ivere27/ulva/docs/schematic/index.html

# ULVA · Schematics

Download PDF

## Pages

×

Opening schematic pages…

Drag to pan · Scroll or pinch to zoom
