ivere27/ulva/docs/images/pcb-placement.png

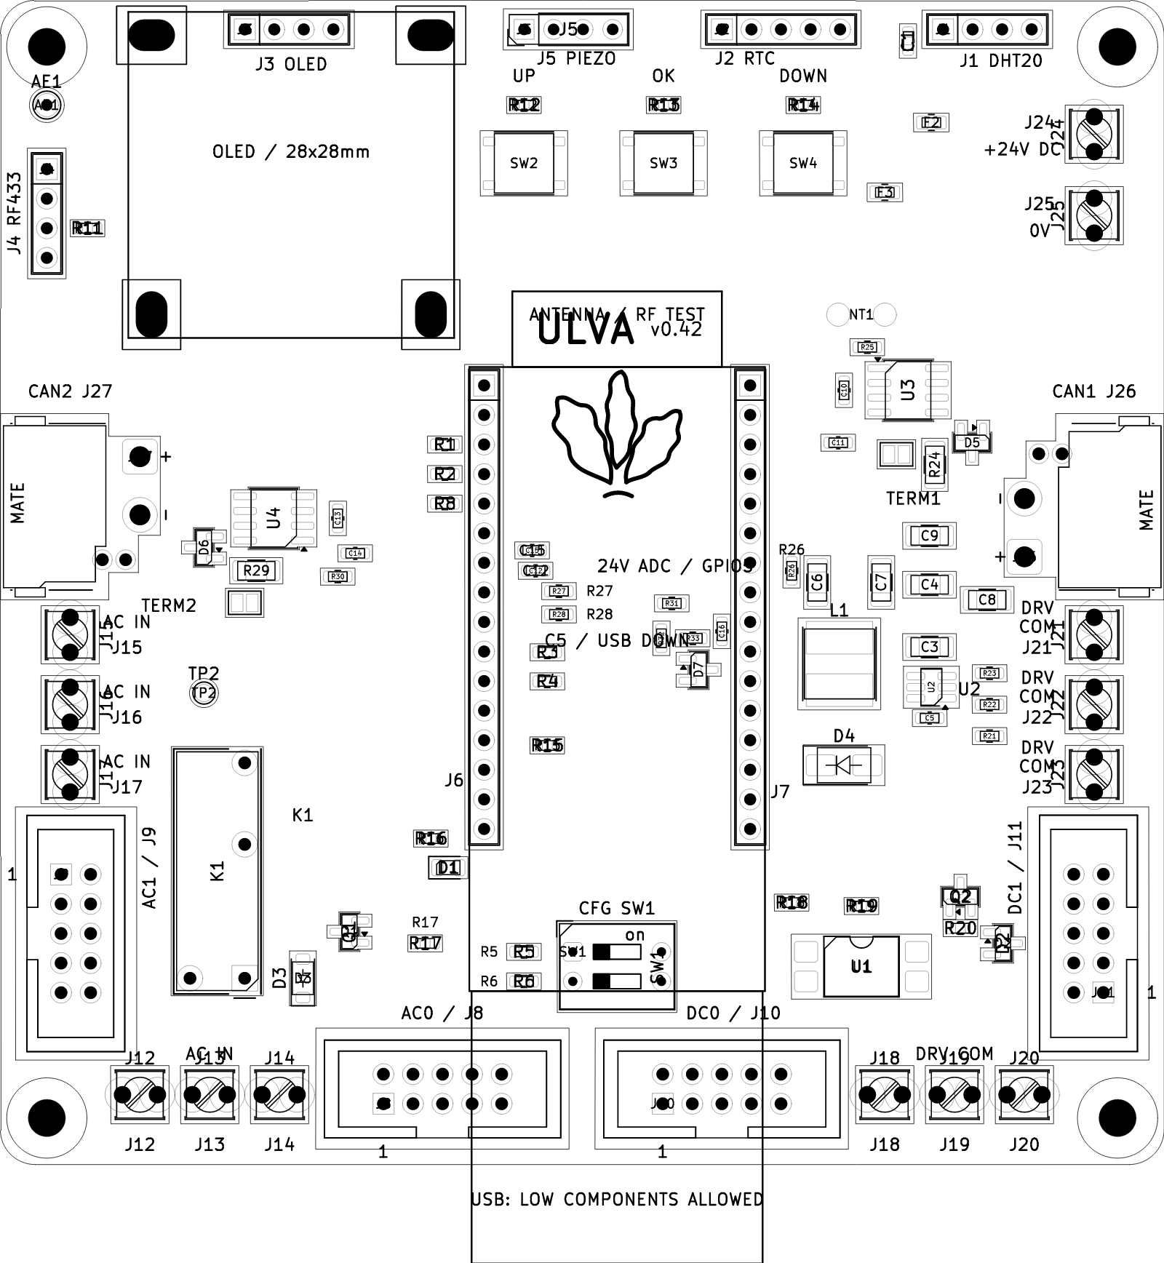
docs/images/pcb-placement.png
