ivere27/ulva/docs/schematic/schematic.pdf

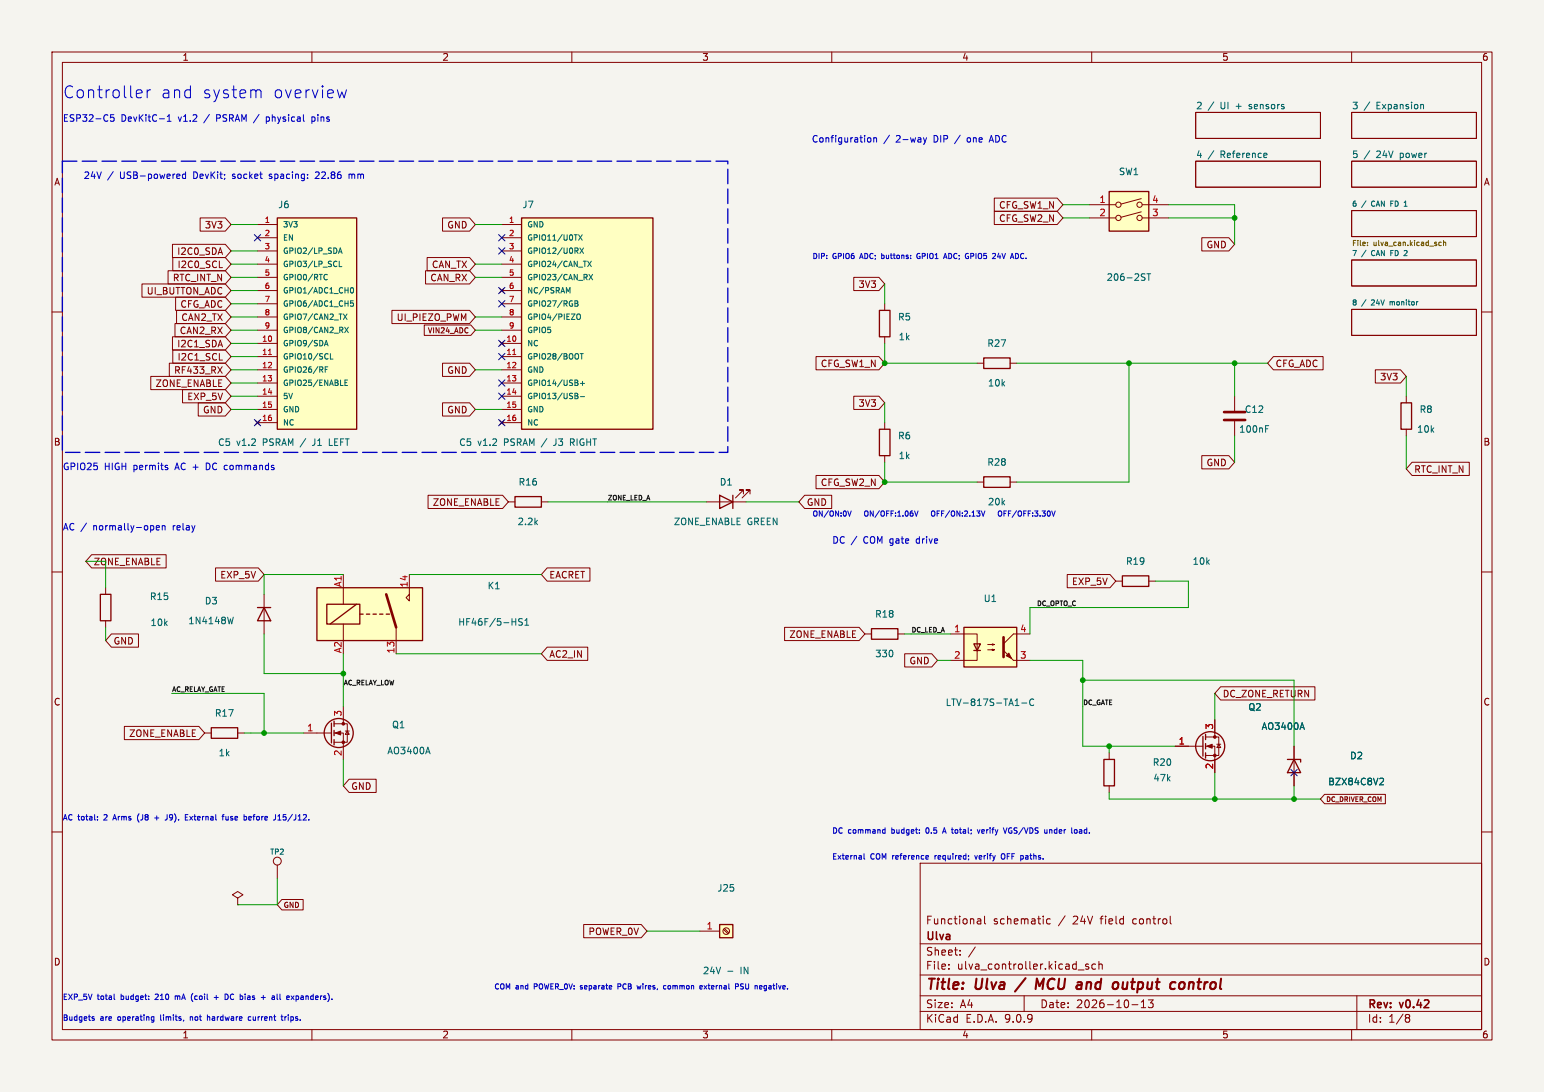
[picture p6: page 1]

6 / CAN FD 1 File: ulva_can.kicad_sch 5 / 24V power 3 / Expansion

DC / COM gate drive

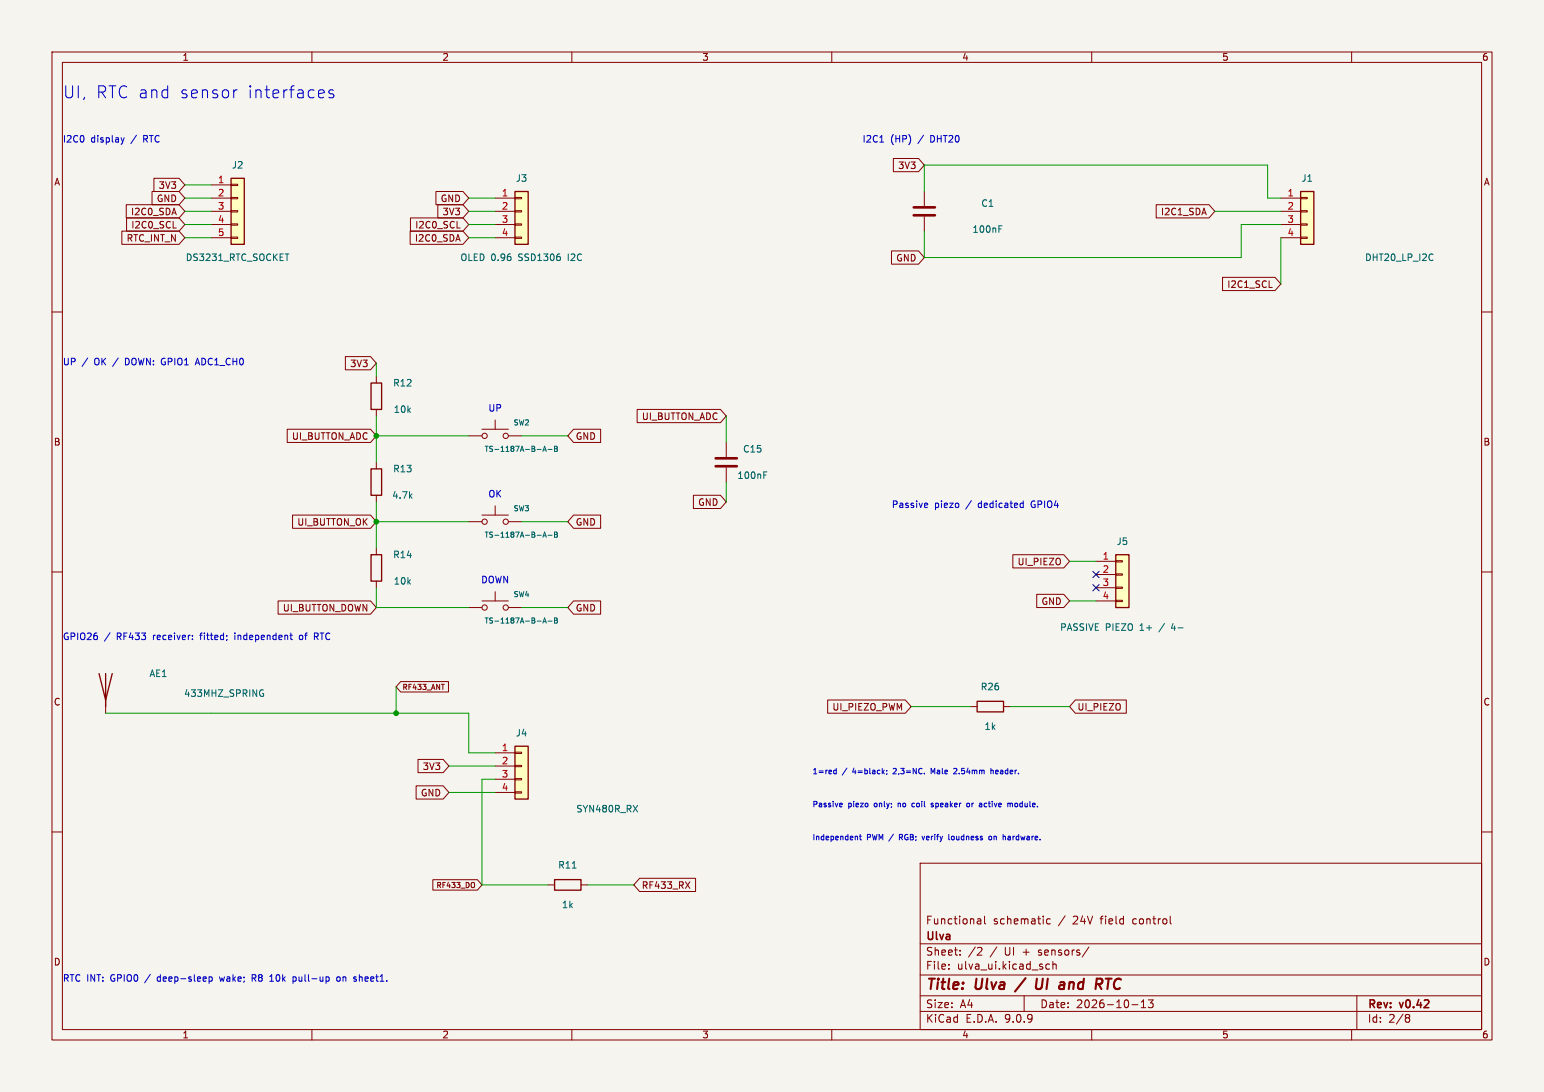
[picture p7: page 2]

UI, RTC and sensor interfaces

Id: 2/8 Title: Ulva / UI and RTC

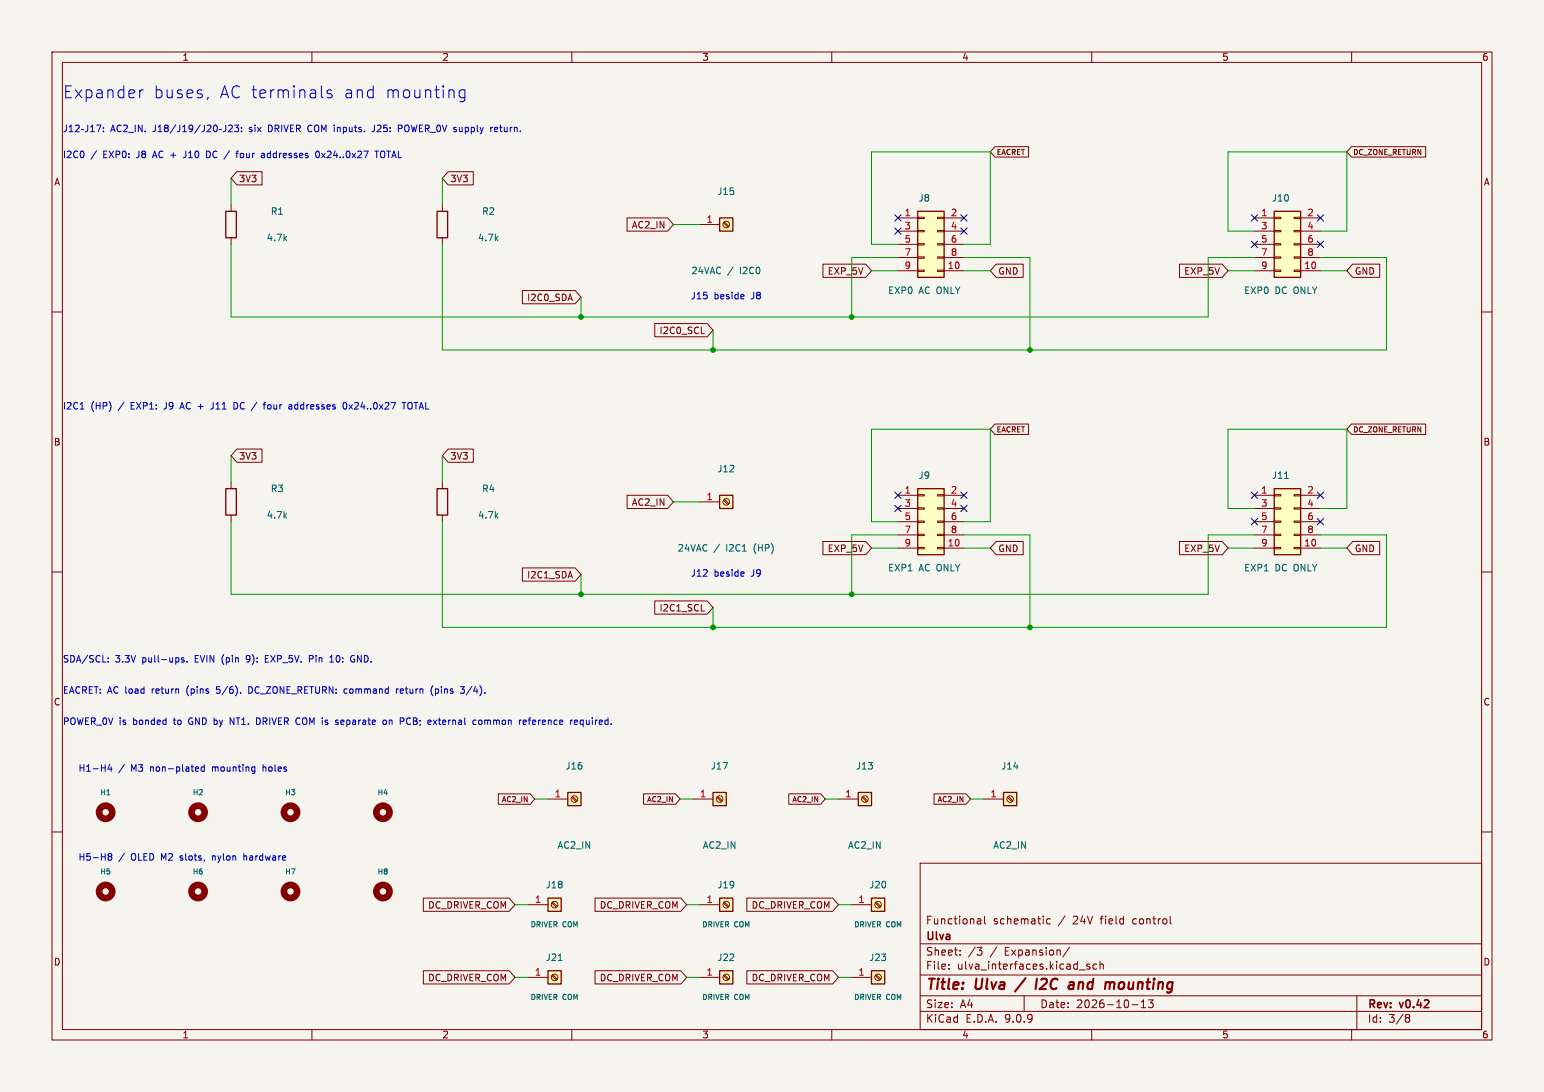
[picture p8: page 3]

Id: 3/8 Title: Ulva / I2C and mounting

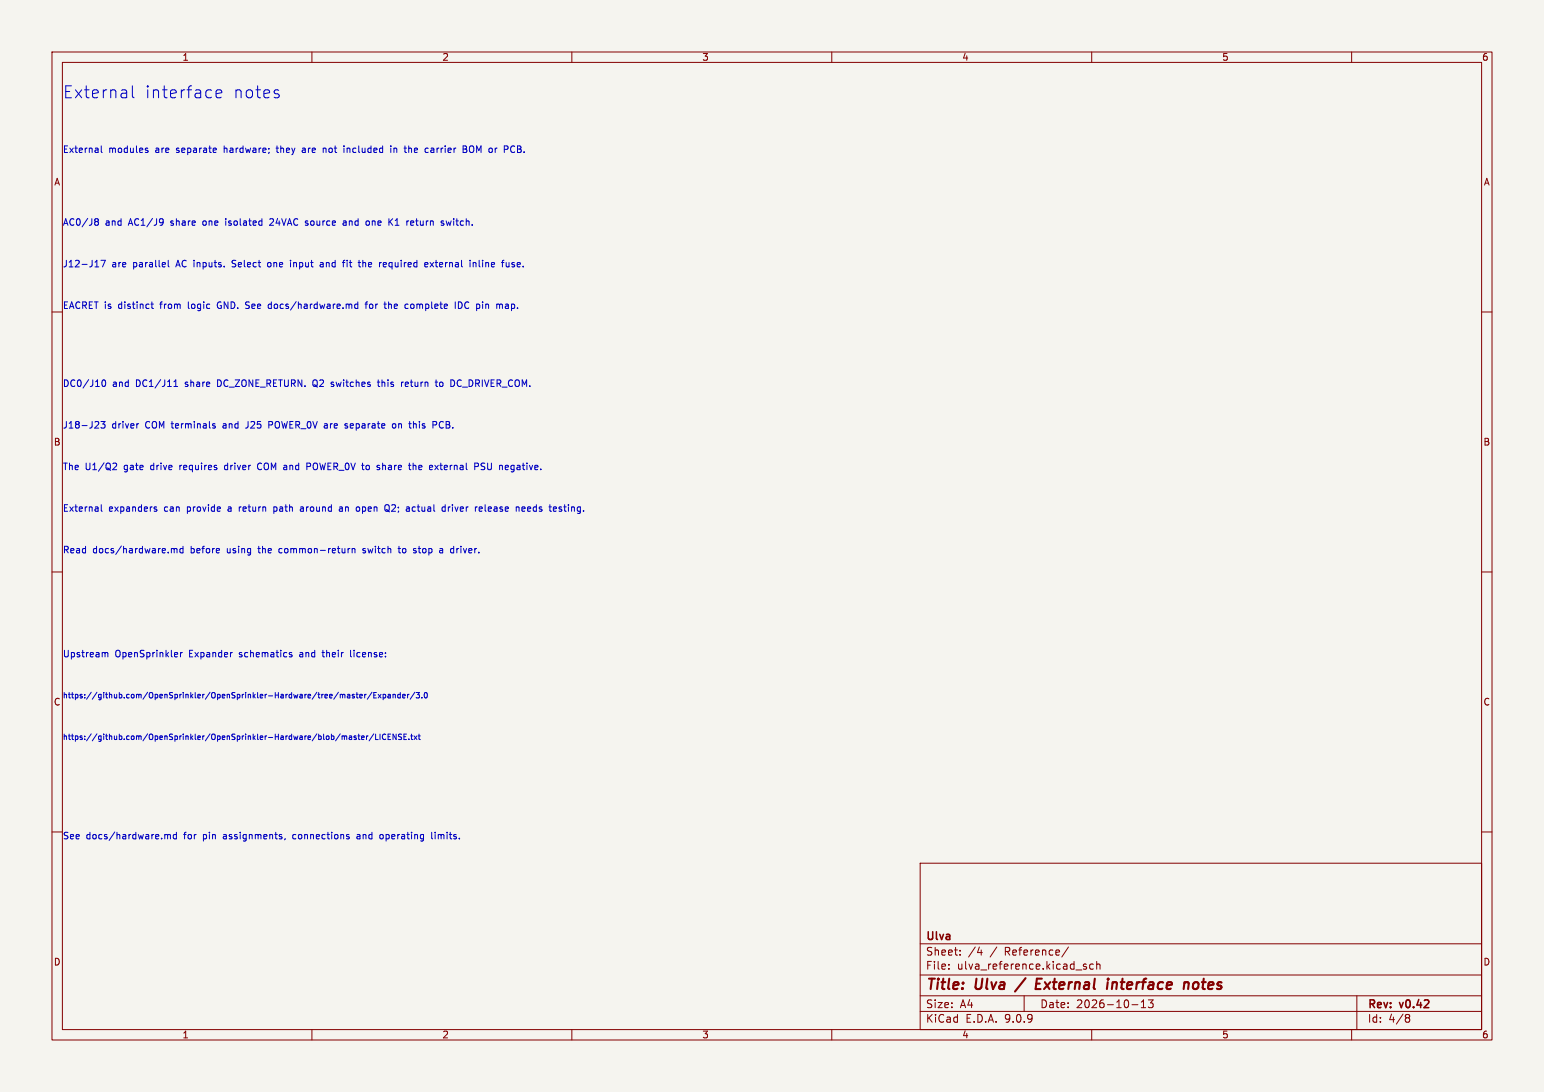
[picture p9: page 4]

Id: 4/8 Title: Ulva / External interface notes

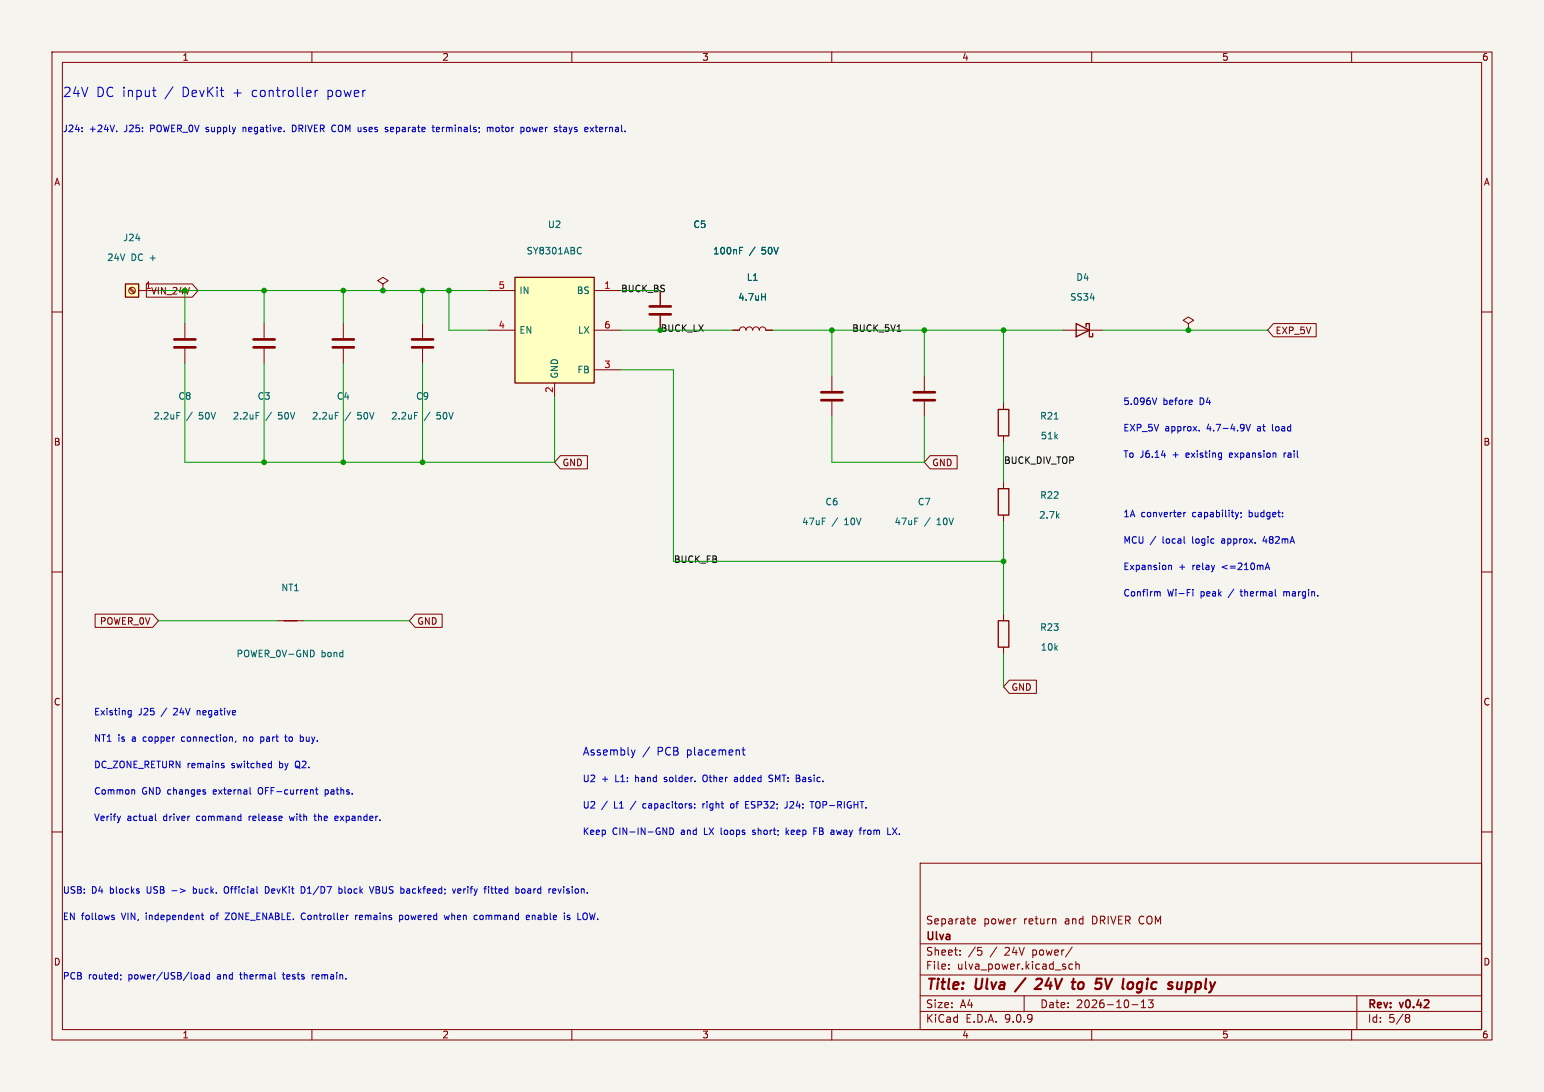
[picture p10: page 5]

Id: 5/8 Title: Ulva / 24V to 5V logic supply

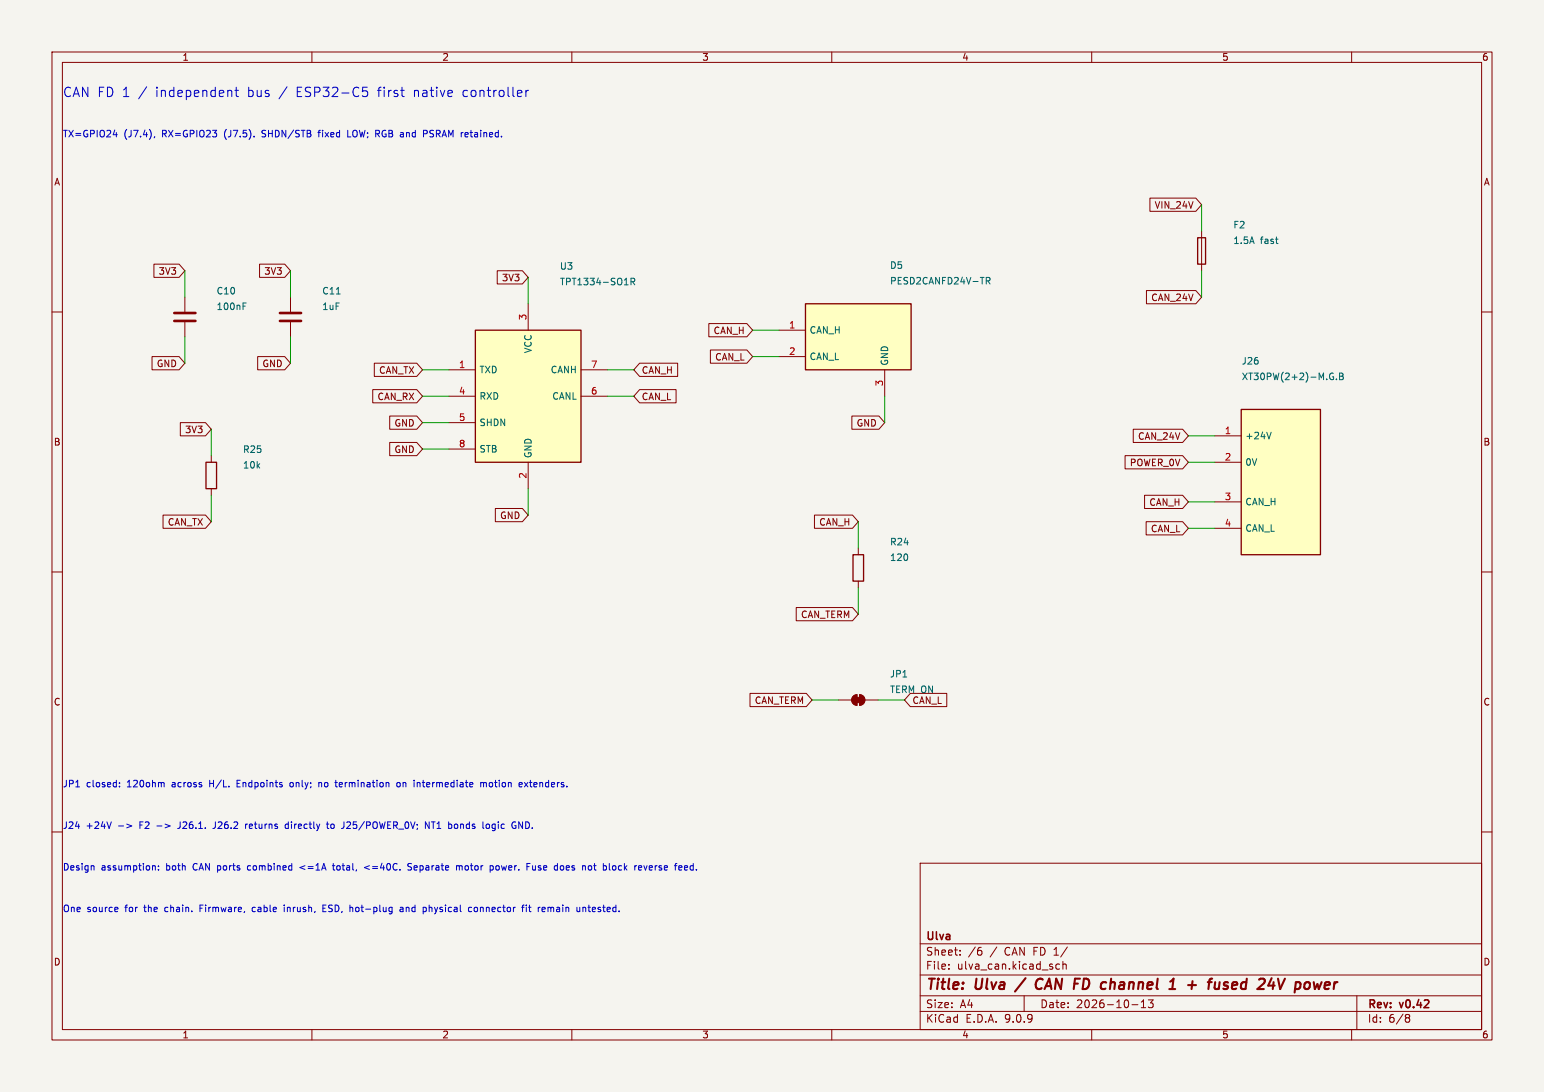
[picture p11: page 6]

TX=GPIO24 (J7.4), RX=GPIO23 (J7.5). SHDN/STB fixed LOW; RGB and PSRAM retained.

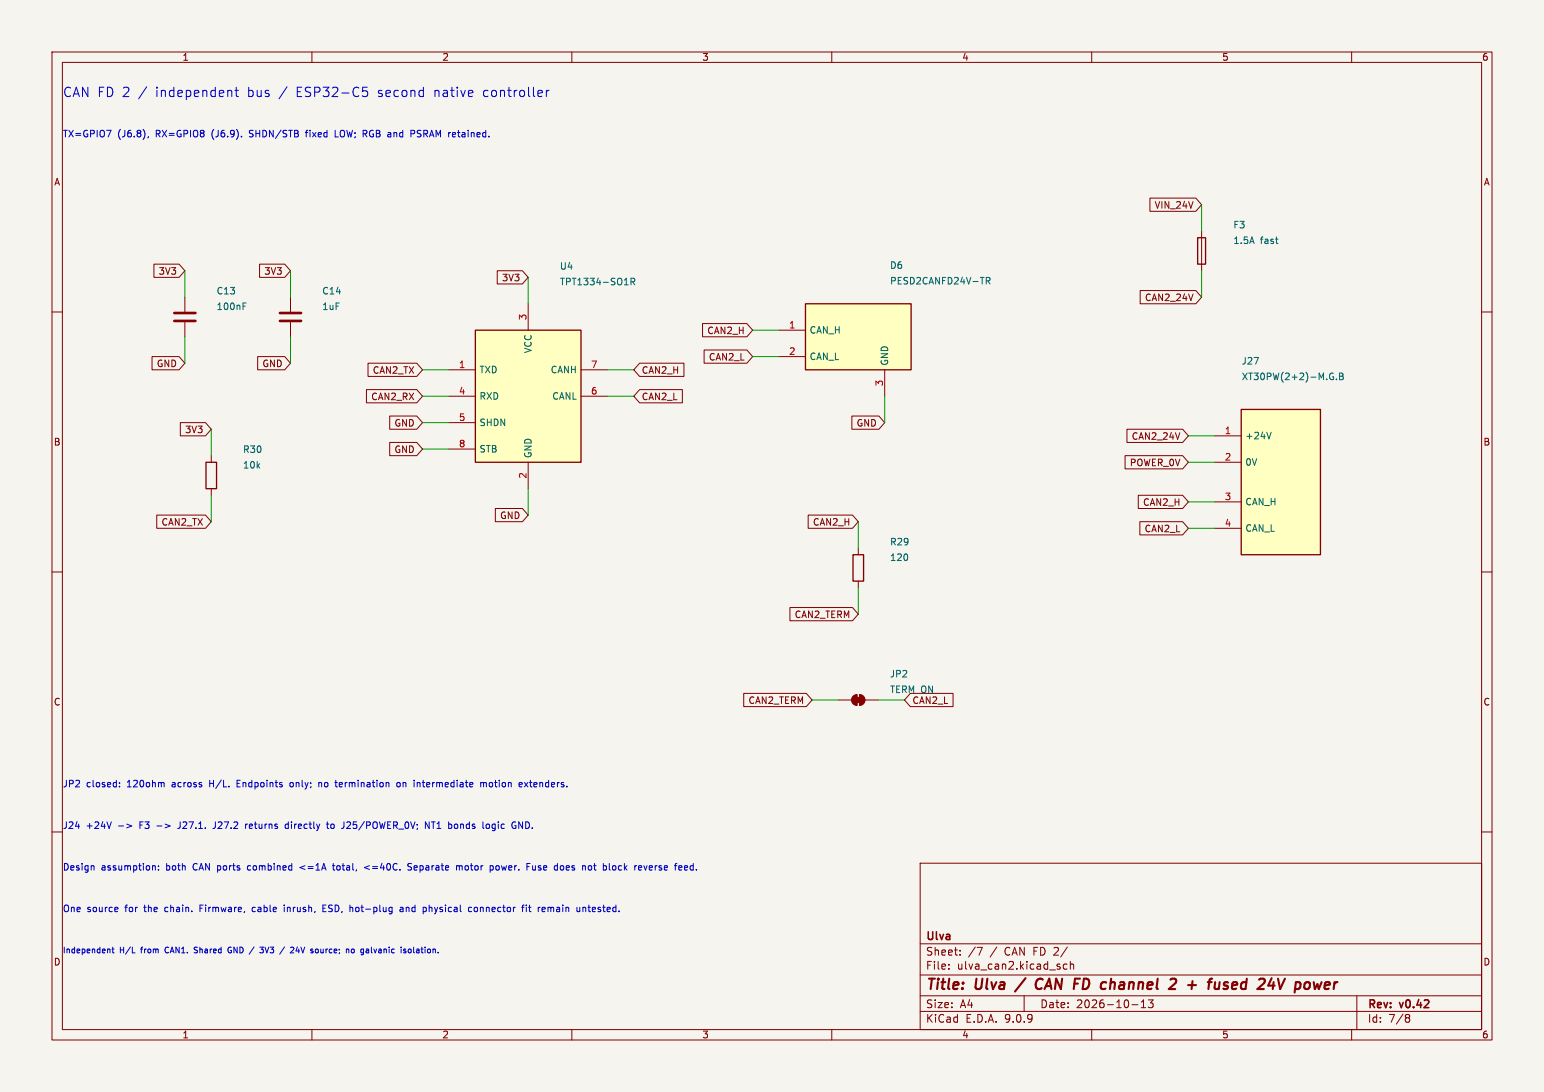
[picture p12: page 7]

TX=GPIO7 (J6.8), RX=GPIO8 (J6.9). SHDN/STB fixed LOW; RGB and PSRAM retained.

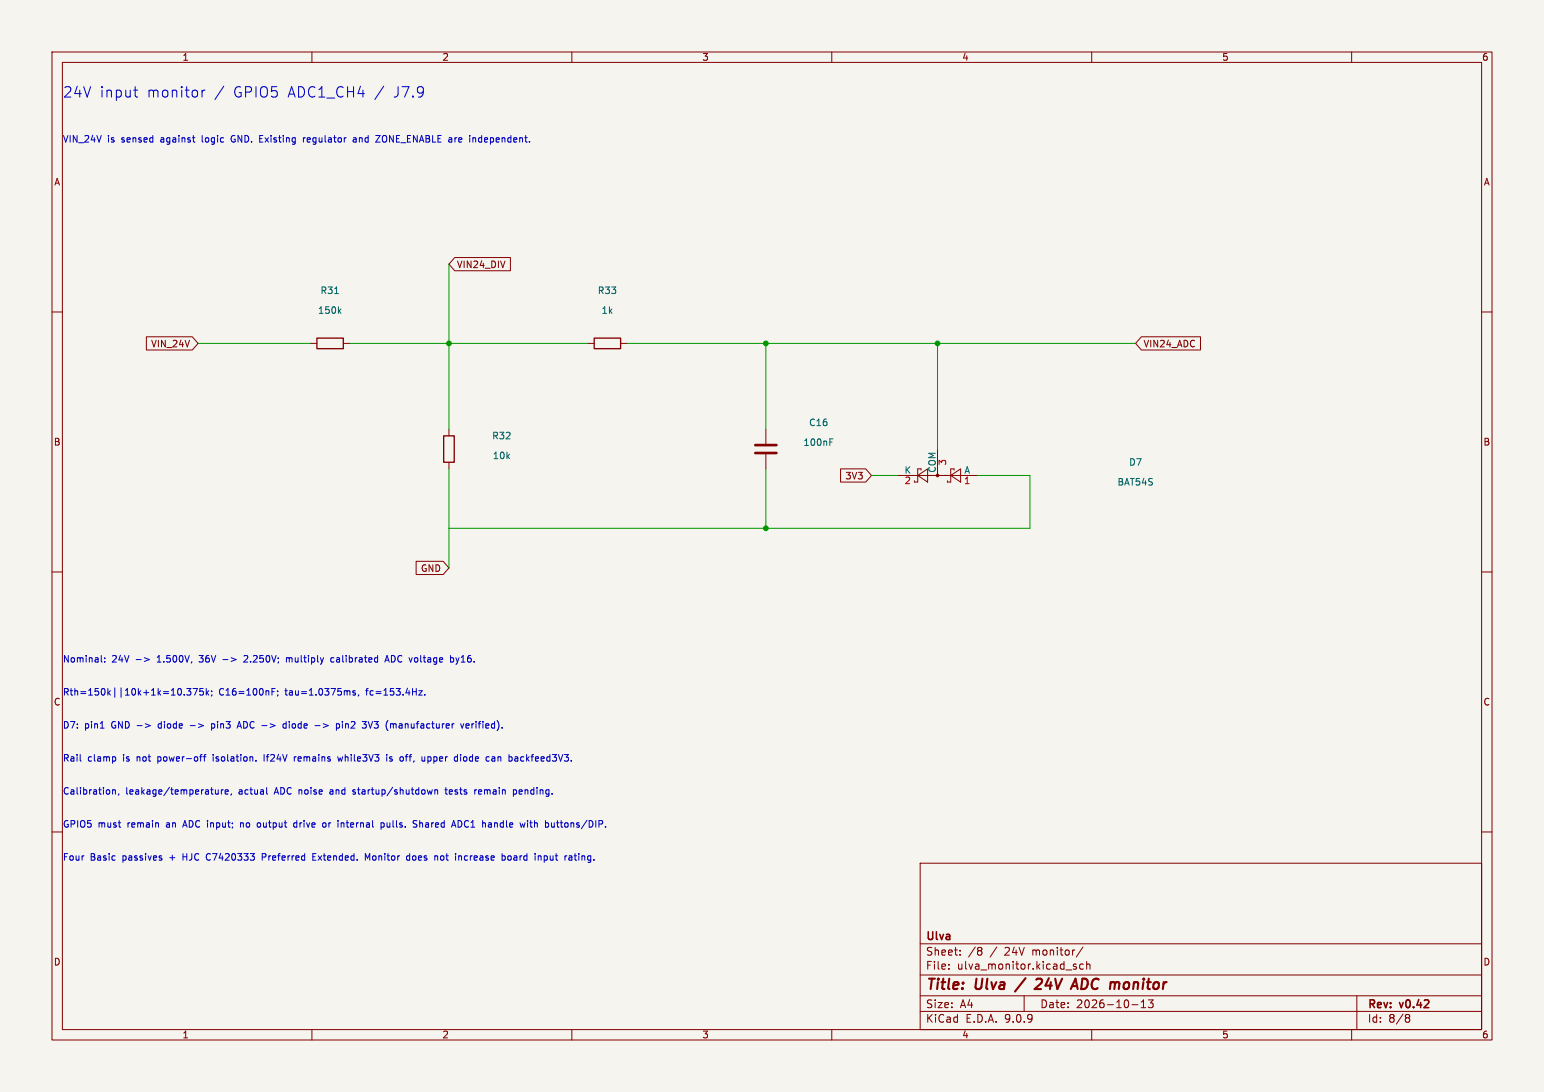
[picture p13: page 8]

Id: 8/8 Title: Ulva / 24V ADC monitor File: ulva_monitor.kicad_sch Sheet: /8 / 24V monitor/ Ulva
