ivere27/ulva/ulva_controller.kicad_pcb

## KiCad design ulva_controller.kicad_pcb (2026-10-23)

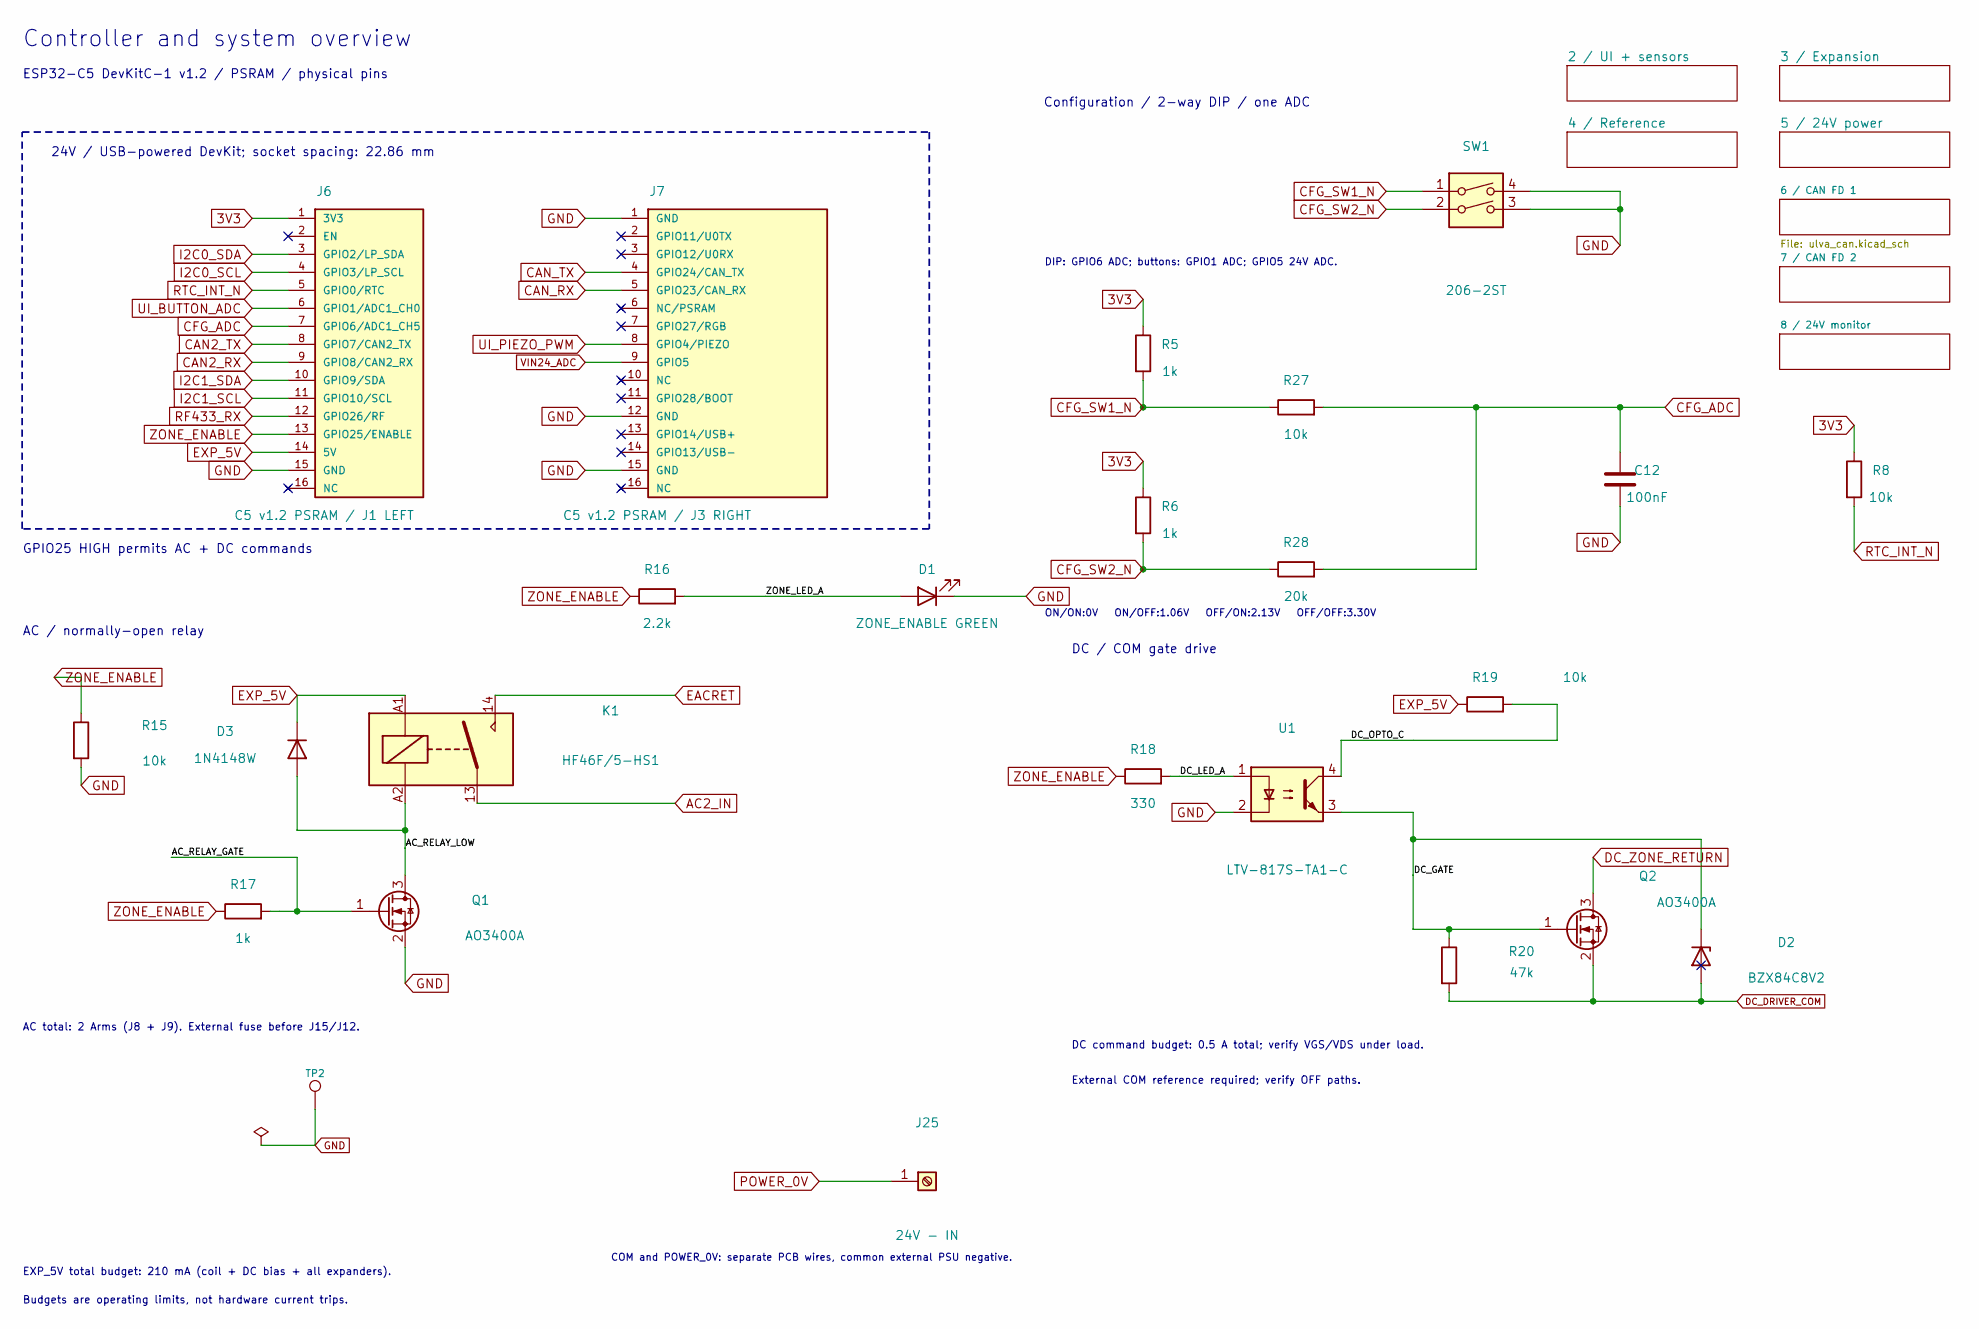
[picture p14: schematic ulva_controller.kicad_sch, Ulva / MCU and output control]

Parts:
C12: 100nF; C_0603_1608Metric; MPN CC0603KRX7R9BB104; LCSC C14663
D1: ZONE_ENABLE GREEN; LED_0805_2012Metric; MPN KT-0805G; LCSC C2297
D2: BZX84C8V2; SOT-23; MPN BZX84C8V2; LCSC C22395522
D3: 1N4148W; D_SOD-123; MPN 1N4148W; LCSC C81598
J6: C5 v1.2 PSRAM / J1 LEFT; Samtec_SSW-116-01-G-S_1x16_P2.54mm; MPN SSW-116-01-G-S
J7: C5 v1.2 PSRAM / J3 RIGHT; Samtec_SSW-116-01-G-S_1x16_P2.54mm; MPN SSW-116-01-G-S
J25: 24V - IN; TerminalBlock_MetzConnect_360272_1x01_Horizontal_ScrewM2.6; MPN 360272
K1: HF46F/5-HS1; Relay_SPST_Hongfa_HF46F_HS1; MPN HF46F/5-HS1
Q1, Q2: AO3400A; SOT-23; MPN AO3400A; LCSC C20917
R5, R6, R17: 1k; R_0603_1608Metric; MPN 0603WAF1001T5E; LCSC C21190
R8, R15, R19, R27: 10k; R_0603_1608Metric; MPN 0603WAF1002T5E; LCSC C25804
R16: 2.2k; R_0603_1608Metric; MPN 0603WAF2201T5E; LCSC C4190
R18: 330; R_0603_1608Metric; MPN 0603WAF3300T5E; LCSC C23138
R20: 47k; R_0603_1608Metric; MPN 0603WAF4702T5E; LCSC C25819
R28: 20k; R_0603_1608Metric; MPN 0603WAF2002T5E; LCSC C4184
SW1: 206-2ST; SW_DIP_SPSTx02_Slide_9.78x7.26mm_W7.62mm_P2.54mm; MPN 206-2ST
TP2: GND; TestPoint_Pad_D1.5mm
U1: LTV-817S-TA1-C; SMDIP-4_W9.53mm; MPN LTV-817S-TA1-C; LCSC C109227

Connections:
3V3: J6.1 (3V3), R5.1, R6.1, R8.1; also elsewhere on the board
/AC_RELAY_GATE: Q1.1 (G), R17.2
/AC_RELAY_LOW: D3.2 (A), K1.A2, Q1.3 (D)
/DC_GATE: D2.3 (K), Q2.1 (G), R20.1, U1.3
/DC_LED_A: R18.2, U1.1
/DC_OPTO_C: R19.2, U1.4
/ZONE_LED_A: D1.2 (A), R16.2
AC2_IN: K1.13; also elsewhere on the board
CAN2_RX: J6.9 (GPIO8/CAN2_RX); also elsewhere on the board
CAN2_TX: J6.8 (GPIO7/CAN2_TX); also elsewhere on the board
CAN_RX: J7.5 (GPIO23/CAN_RX); also elsewhere on the board
CAN_TX: J7.4 (GPIO24/CAN_TX); also elsewhere on the board
CFG_ADC: C12.1, J6.7 (GPIO6/ADC1_CH5), R27.2, R28.2
CFG_SW1_N: R5.2, R27.1, SW1.1
CFG_SW2_N: R6.2, R28.1, SW1.2
DC_DRIVER_COM: D2.1 (A), Q2.2 (S), R20.2; also elsewhere on the board
DC_ZONE_RETURN: Q2.3 (D); also elsewhere on the board
EACRET: K1.14; also elsewhere on the board
EXP_5V: D3.1 (K), J6.14 (5V), K1.A1, R19.1; also elsewhere on the board
GND: C12.2, D1.1 (K), J6.15 (GND), J7.1 (GND), J7.12 (GND), J7.15 (GND), Q1.2 (S), R15.2, SW1.3, SW1.4, TP2.1, U1.2; also elsewhere on the board
I2C0_SCL: J6.4 (GPIO3/LP_SCL); also elsewhere on the board
I2C0_SDA: J6.3 (GPIO2/LP_SDA); also elsewhere on the board
I2C1_SCL: J6.11 (GPIO10/SCL); also elsewhere on the board
I2C1_SDA: J6.10 (GPIO9/SDA); also elsewhere on the board
POWER_0V: J25.1; also elsewhere on the board
RF433_RX: J6.12 (GPIO26/RF); also elsewhere on the board
RTC_INT_N: J6.5 (GPIO0/RTC), R8.2; also elsewhere on the board
UI_BUTTON_ADC: J6.6 (GPIO1/ADC1_CH0); also elsewhere on the board
UI_PIEZO_PWM: J7.8 (GPIO4/PIEZO); also elsewhere on the board
VIN24_ADC: J7.9 (GPIO5); also elsewhere on the board
ZONE_ENABLE: J6.13 (GPIO25/ENABLE), R15.1, R16.1, R17.1, R18.1

Notes on the sheet:
Controller and system overview
ESP32-C5 DevKitC-1 v1.2 / PSRAM / physical pins
Configuration / 2-way DIP / one ADC
GPIO25 HIGH permits AC + DC commands
24V / USB-powered DevKit; socket spacing: 22.86 mm
AC / normally-open relay
DC / COM gate drive
AC total: 2 Arms (J8 + J9). External fuse before J15/J12.
DC command budget: 0.5 A total; verify VGS/VDS under load.
EXP_5V total budget: 210 mA (coil + DC bias + all expanders).
Budgets are operating limits, not hardware current trips.
External COM reference required; verify OFF paths.
COM and POWER_0V: separate PCB wires, common external PSU negative.
DIP: GPIO6 ADC; buttons: GPIO1 ADC; GPIO5 24V ADC.
ON/ON:0V ON/OFF:1.06V OFF/ON:2.13V OFF/OFF:3.30V

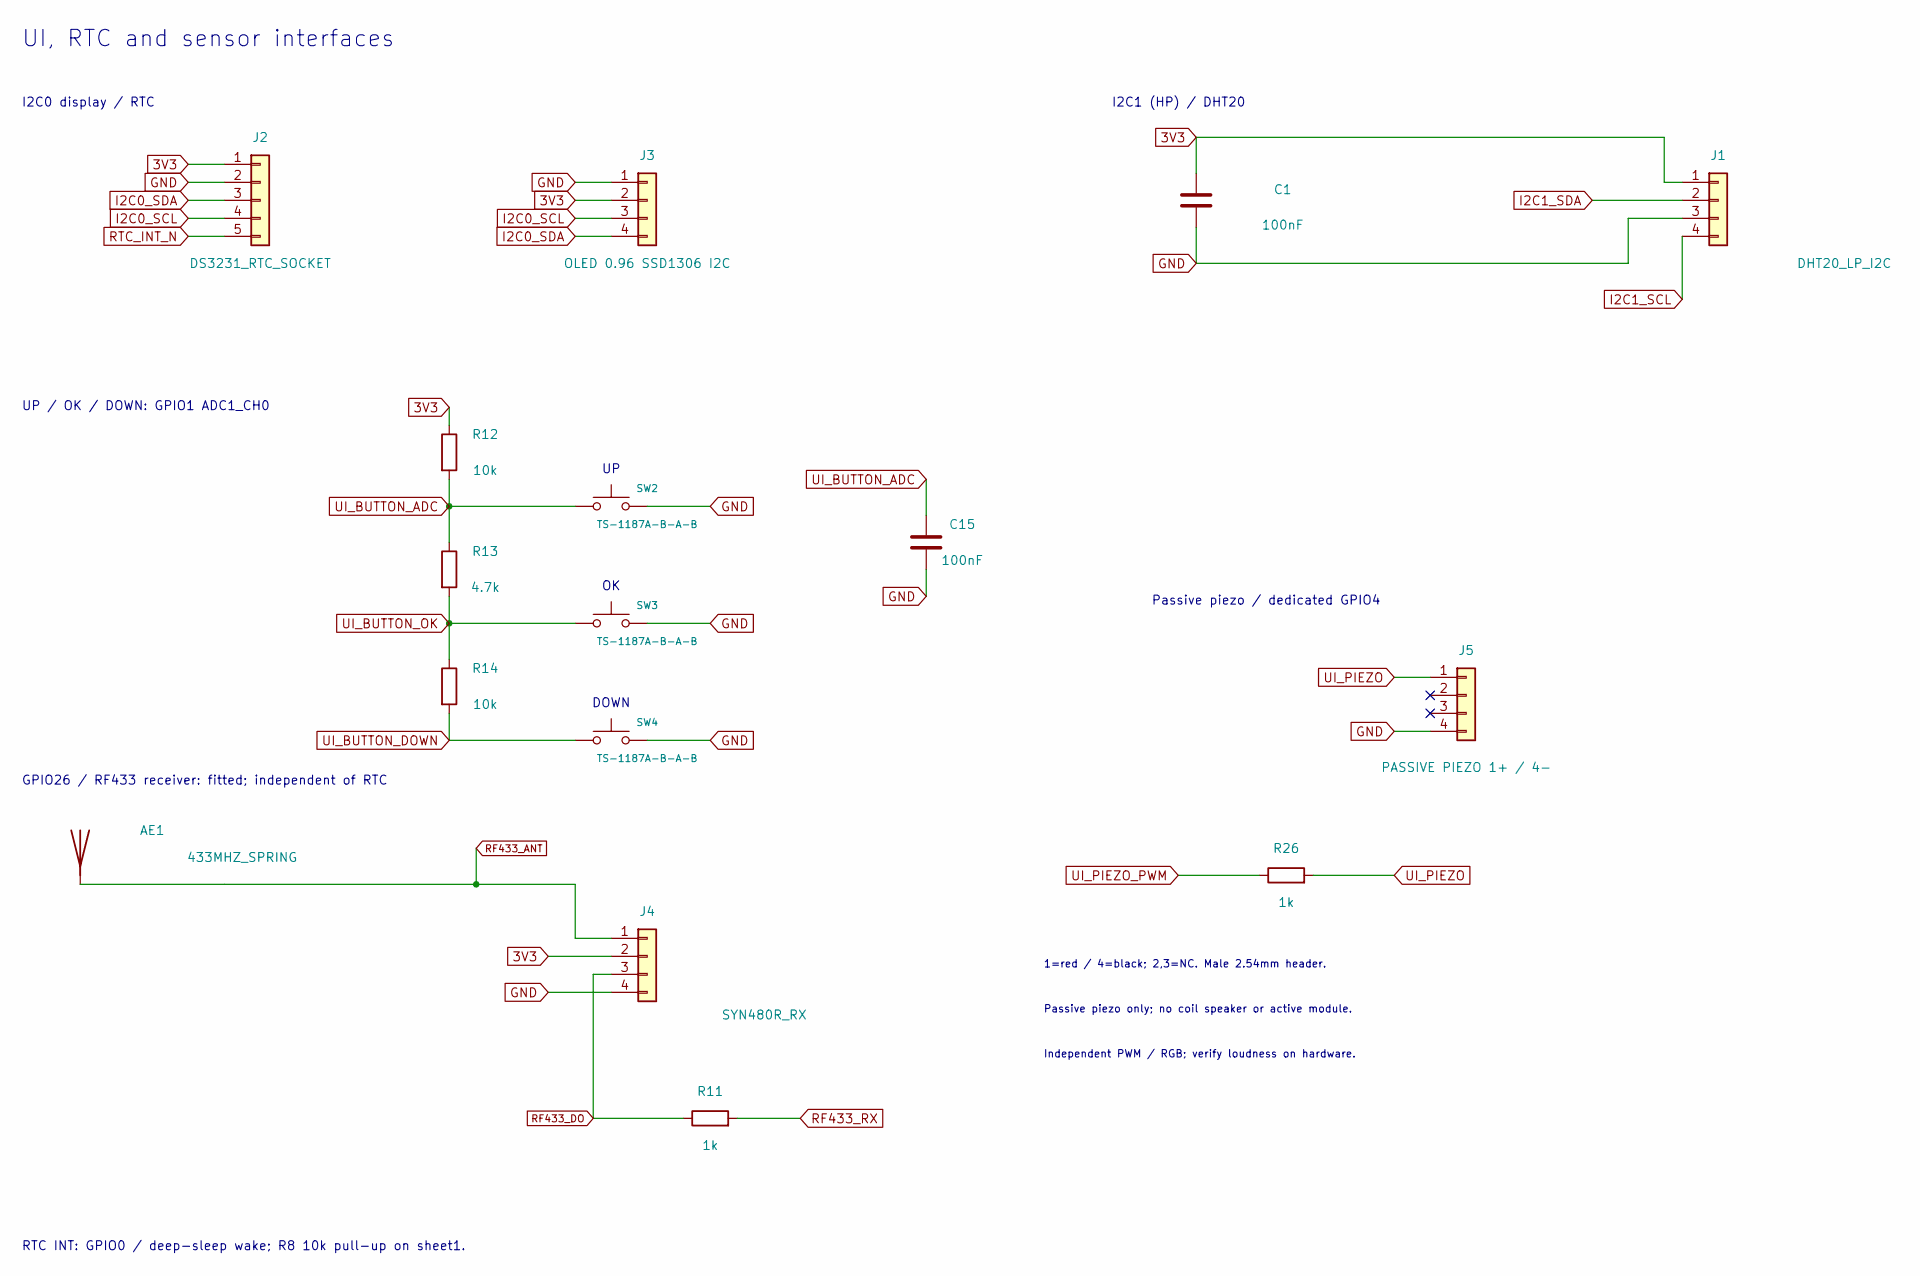
[picture p15: schematic ulva_ui.kicad_sch, Ulva / UI and RTC]

Parts:
AE1: 433MHZ_SPRING; TestPoint_THTPad_D2.0mm_Drill1.0mm
C1, C15: 100nF; C_0603_1608Metric; MPN CC0603KRX7R9BB104; LCSC C14663
J1: DHT20_LP_I2C; Samtec_SSW-104-01-G-S_1x04_P2.54mm; MPN SSW-104-01-G-S
J2: DS3231_RTC_SOCKET; Samtec_SSW-105-01-G-S_1x05_P2.54mm; MPN SSW-105-01-G-S
J3: OLED 0.96 SSD1306 I2C; Samtec_SSW-104-01-G-S_1x04_P2.54mm; MPN SSW-104-01-G-S
J4: SYN480R_RX; Samtec_SSW-104-01-G-S_1x04_P2.54mm; MPN SSW-104-01-G-S
J5: PASSIVE PIEZO 1+ / 4-; PinHeader_1x04_P2.54mm_Vertical
R11, R26: 1k; R_0603_1608Metric; MPN 0603WAF1001T5E; LCSC C21190
R12, R14: 10k; R_0603_1608Metric; MPN 0603WAF1002T5E; LCSC C25804
R13: 4.7k; R_0603_1608Metric; MPN 0603WAF4701T5E; LCSC C23162
SW2, SW3, SW4: TS-1187A-B-A-B; SW_XKB_TS-1187A_5.1x5.1mm; MPN TS-1187A-B-A-B; LCSC C318884

Connections:
3V3: C1.1, J1.1, J2.1, J3.2, J4.2, R12.1; also elsewhere on the board
GND: C1.2, C15.2, J1.3, J2.2, J3.1, J4.4, J5.4, SW2.2, SW3.2, SW4.2; also elsewhere on the board
I2C0_SCL: J2.4, J3.3; also elsewhere on the board
I2C0_SDA: J2.3, J3.4; also elsewhere on the board
I2C1_SCL: J1.4; also elsewhere on the board
I2C1_SDA: J1.2; also elsewhere on the board
RF433_ANT: AE1.1 (A), J4.1
RF433_DO: J4.3, R11.1
RF433_RX: R11.2; also elsewhere on the board
RTC_INT_N: J2.5; also elsewhere on the board
UI_BUTTON_ADC: C15.1, R12.2, R13.1, SW2.1; also elsewhere on the board
UI_BUTTON_DOWN: R14.2, SW4.1
UI_BUTTON_OK: R13.2, R14.1, SW3.1
UI_PIEZO: J5.1, R26.2
UI_PIEZO_PWM: R26.1; also elsewhere on the board

Notes on the sheet:
UI, RTC and sensor interfaces
I2C0 display / RTC
I2C1 (HP) / DHT20
UP / OK / DOWN: GPIO1 ADC1_CH0
GPIO26 / RF433 receiver: fitted; independent of RTC
RTC INT: GPIO0 / deep-sleep wake; R8 10k pull-up on sheet1.
Passive piezo / dedicated GPIO4
1=red / 4=black; 2,3=NC. Male 2.54mm header.
Passive piezo only; no coil speaker or active module.
Independent PWM / RGB; verify loudness on hardware.
DOWN

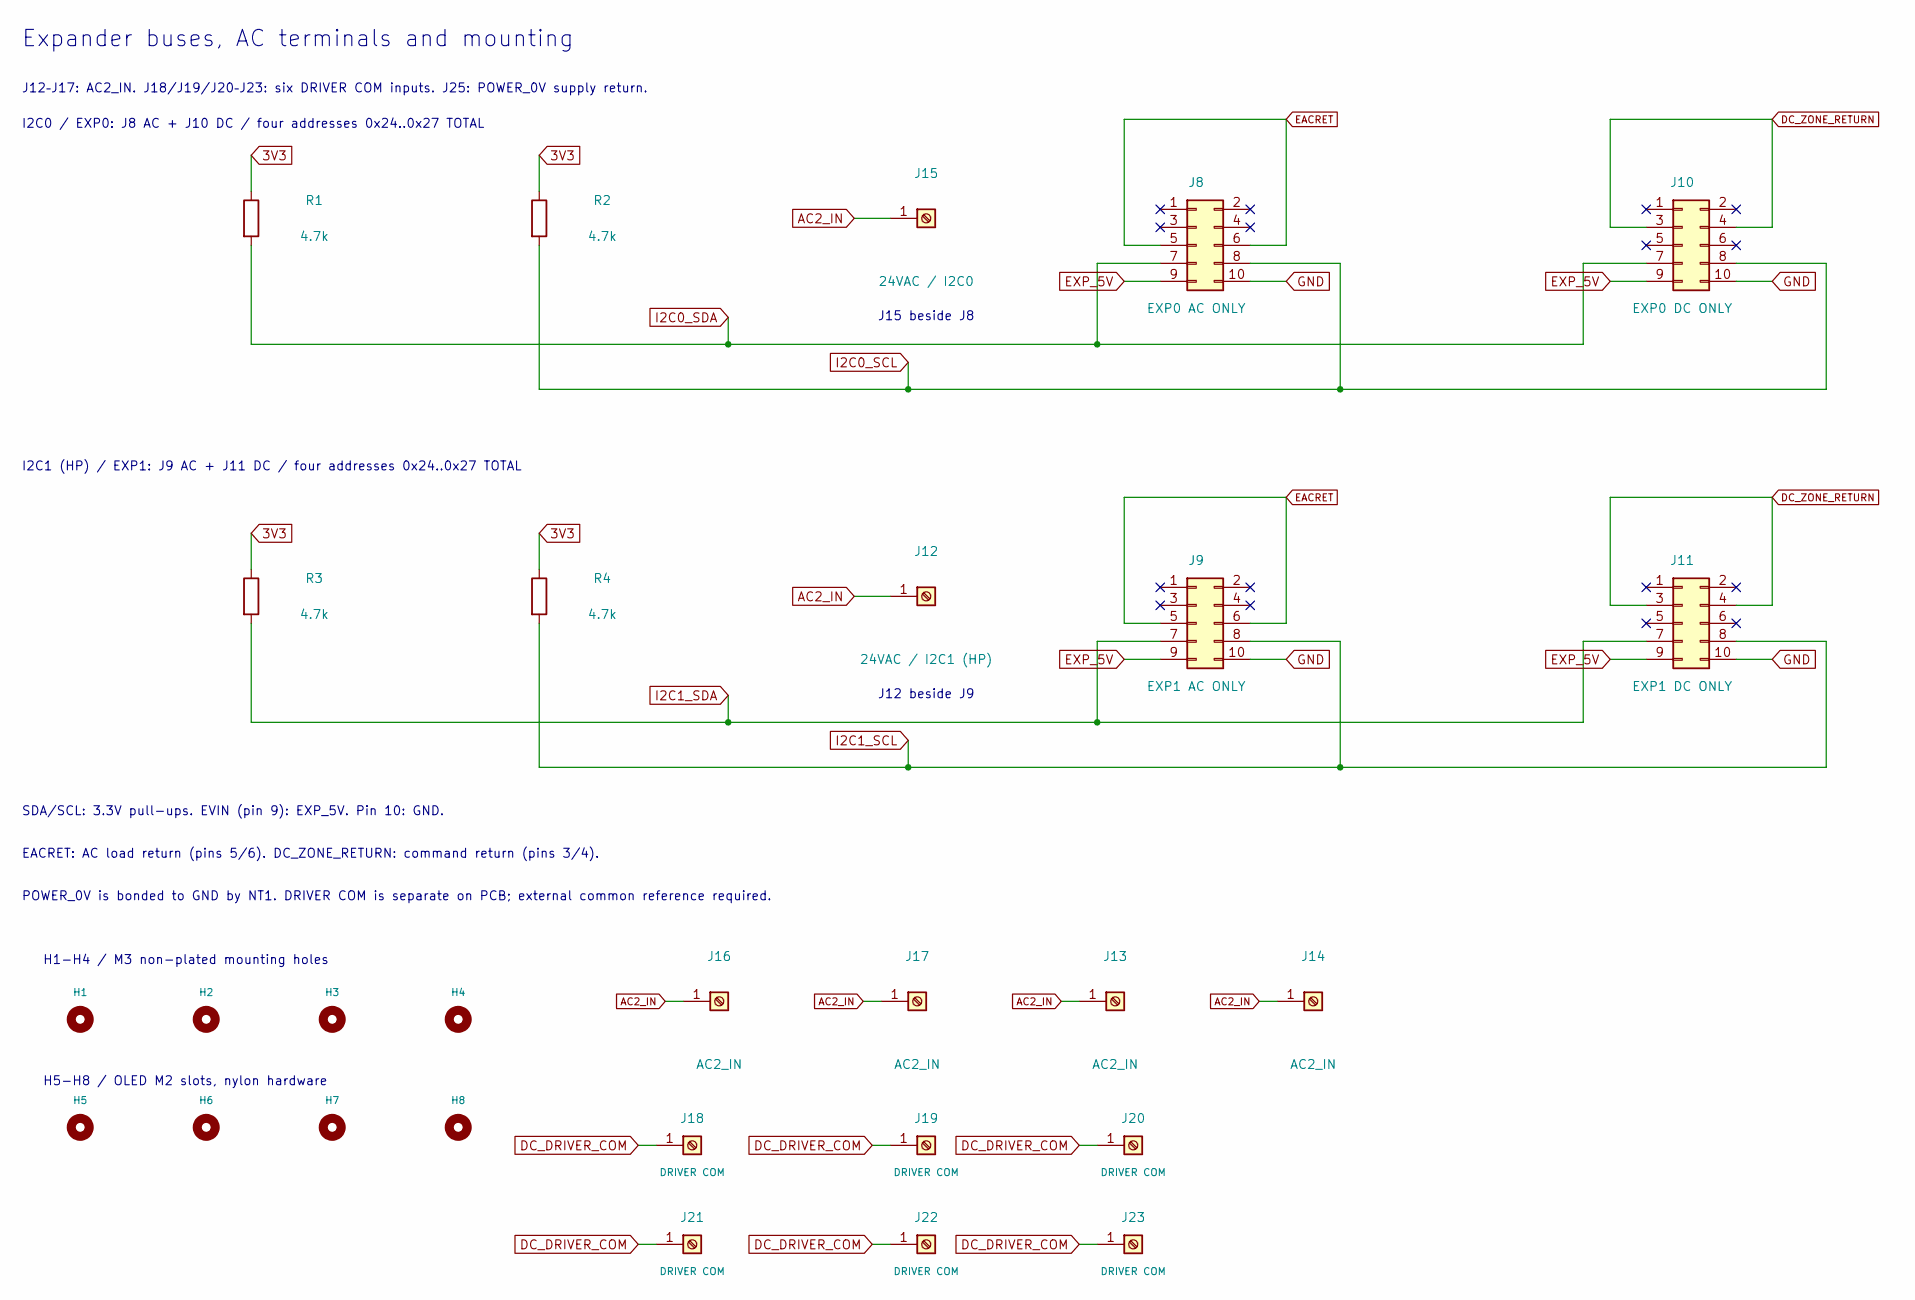
[picture p16: schematic ulva_interfaces.kicad_sch, Ulva / I2C and mounting]

Parts:
H1, H2, H3, H4: M3 NPTH; MountingHole_3.2mm_M3
H5, H6, H7, H8: OLED M2 SLOT; MountingSlot_4.0x2.7mm_M2_OLED
J8: EXP0 AC ONLY; ZHOURI_DC3-2.54-10PAS_IDC_2x05_P2.54mm; MPN DC3-2.54-10PAS; LCSC C2977596
J9: EXP1 AC ONLY; ZHOURI_DC3-2.54-10PAS_IDC_2x05_P2.54mm; MPN DC3-2.54-10PAS; LCSC C2977596
J10: EXP0 DC ONLY; ZHOURI_DC3-2.54-10PAS_IDC_2x05_P2.54mm; MPN DC3-2.54-10PAS; LCSC C2977596
J11: EXP1 DC ONLY; ZHOURI_DC3-2.54-10PAS_IDC_2x05_P2.54mm; MPN DC3-2.54-10PAS; LCSC C2977596
J12: 24VAC / I2C1 (HP); TerminalBlock_MetzConnect_360272_1x01_Horizontal_ScrewM2.6; MPN 360272
J13, J14, J16, J17: AC2_IN; TerminalBlock_MetzConnect_360272_1x01_Horizontal_ScrewM2.6; MPN 360272
J15: 24VAC / I2C0; TerminalBlock_MetzConnect_360272_1x01_Horizontal_ScrewM2.6; MPN 360272
J18, J19, J20, J21, J22, J23: DRIVER COM; TerminalBlock_MetzConnect_360272_1x01_Horizontal_ScrewM2.6; MPN 360272
R1, R2, R3, R4: 4.7k; R_0603_1608Metric; MPN 0603WAF4701T5E; LCSC C23162

Connections:
3V3: R1.1, R2.1, R3.1, R4.1; also elsewhere on the board
AC2_IN: J12.1, J13.1, J14.1, J15.1, J16.1, J17.1; also elsewhere on the board
DC_DRIVER_COM: J18.1, J19.1, J20.1, J21.1, J22.1, J23.1; also elsewhere on the board
DC_ZONE_RETURN: J10.3, J10.4, J11.3, J11.4; also elsewhere on the board
EACRET: J8.5, J8.6, J9.5, J9.6; also elsewhere on the board
EXP_5V: J8.9, J9.9, J10.9, J11.9; also elsewhere on the board
GND: J8.10, J9.10, J10.10, J11.10; also elsewhere on the board
I2C0_SCL: J8.8, J10.8, R2.2; also elsewhere on the board
I2C0_SDA: J8.7, J10.7, R1.2; also elsewhere on the board
I2C1_SCL: J9.8, J11.8, R4.2; also elsewhere on the board
I2C1_SDA: J9.7, J11.7, R3.2; also elsewhere on the board

Notes on the sheet:
Expander buses, AC terminals and mounting
I2C0 / EXP0: J8 AC + J10 DC / four addresses 0x24..0x27 TOTAL
I2C1 (HP) / EXP1: J9 AC + J11 DC / four addresses 0x24..0x27 TOTAL
SDA/SCL: 3.3V pull-ups. EVIN (pin 9): EXP_5V. Pin 10: GND.
EACRET: AC load return (pins 5/6). DC_ZONE_RETURN: command return (pins 3/4).
POWER_0V is bonded to GND by NT1. DRIVER COM is separate on PCB; external common reference required.
H1-H4 / M3 non-plated mounting holes
H5-H8 / OLED M2 slots, nylon hardware
J15 beside J8
J12 beside J9
J12–J17: AC2_IN. J18/J19/J20–J23: six DRIVER COM inputs. J25: POWER_0V supply return.

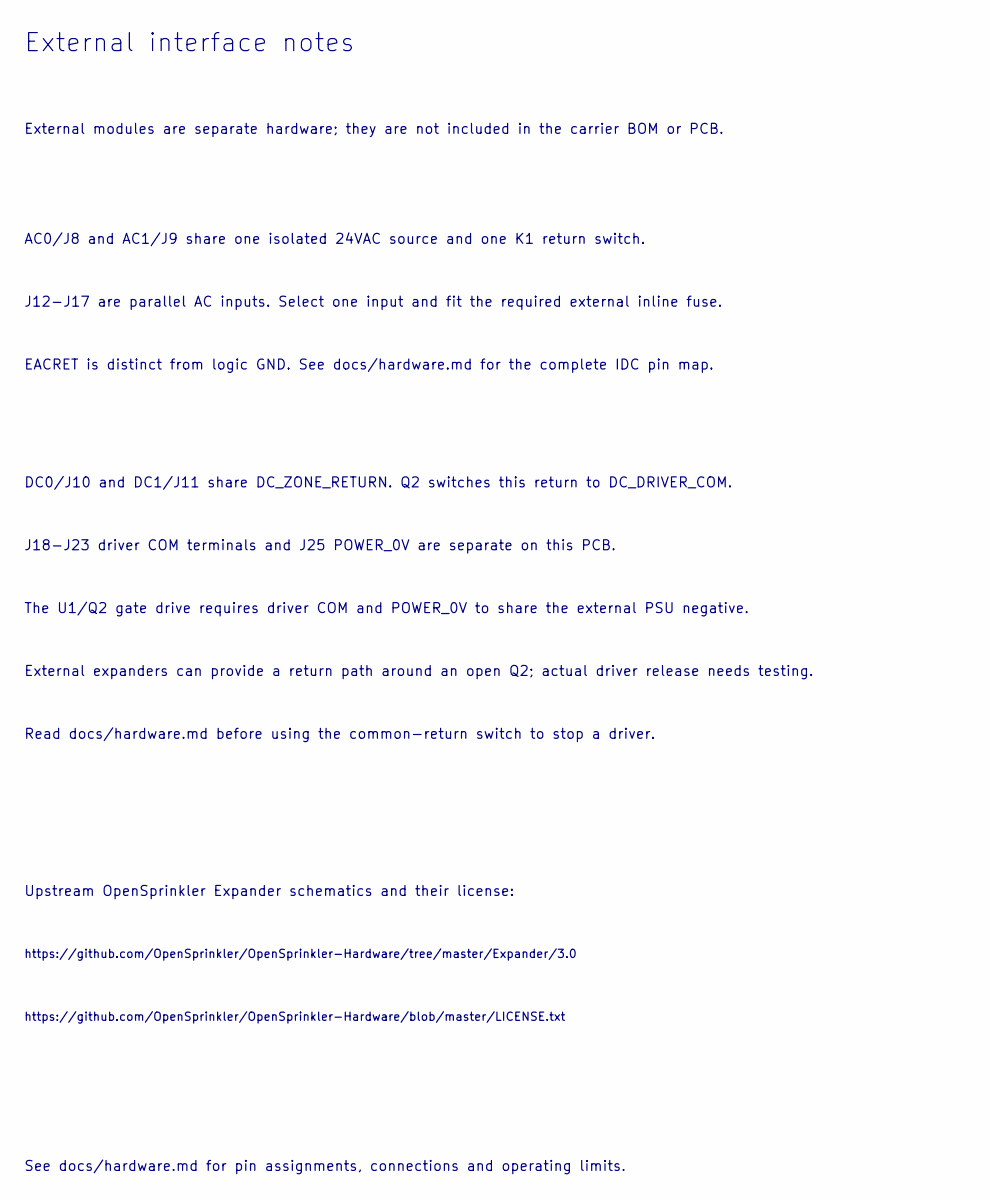
[picture p17: schematic ulva_reference.kicad_sch, Ulva / External interface notes]

Notes on the sheet:
External interface notes
External modules are separate hardware; they are not included in the carrier BOM or PCB.
AC0/J8 and AC1/J9 share one isolated 24VAC source and one K1 return switch.
J12-J17 are parallel AC inputs. Select one input and fit the required external inline fuse.
EACRET is distinct from logic GND. See docs/hardware.md for the complete IDC pin map.
DC0/J10 and DC1/J11 share DC_ZONE_RETURN. Q2 switches this return to DC_DRIVER_COM.
J18-J23 driver COM terminals and J25 POWER_0V are separate on this PCB.
The U1/Q2 gate drive requires driver COM and POWER_0V to share the external PSU negative.
External expanders can provide a return path around an open Q2; actual driver release needs testing.
Read docs/hardware.md before using the common-return switch to stop a driver.
Upstream OpenSprinkler Expander schematics and their license:
https://github.com/OpenSprinkler/OpenSprinkler-Hardware/tree/master/Expander/3.0
https://github.com/OpenSprinkler/OpenSprinkler-Hardware/blob/master/LICENSE.txt
See docs/hardware.md for pin assignments, connections and operating limits.

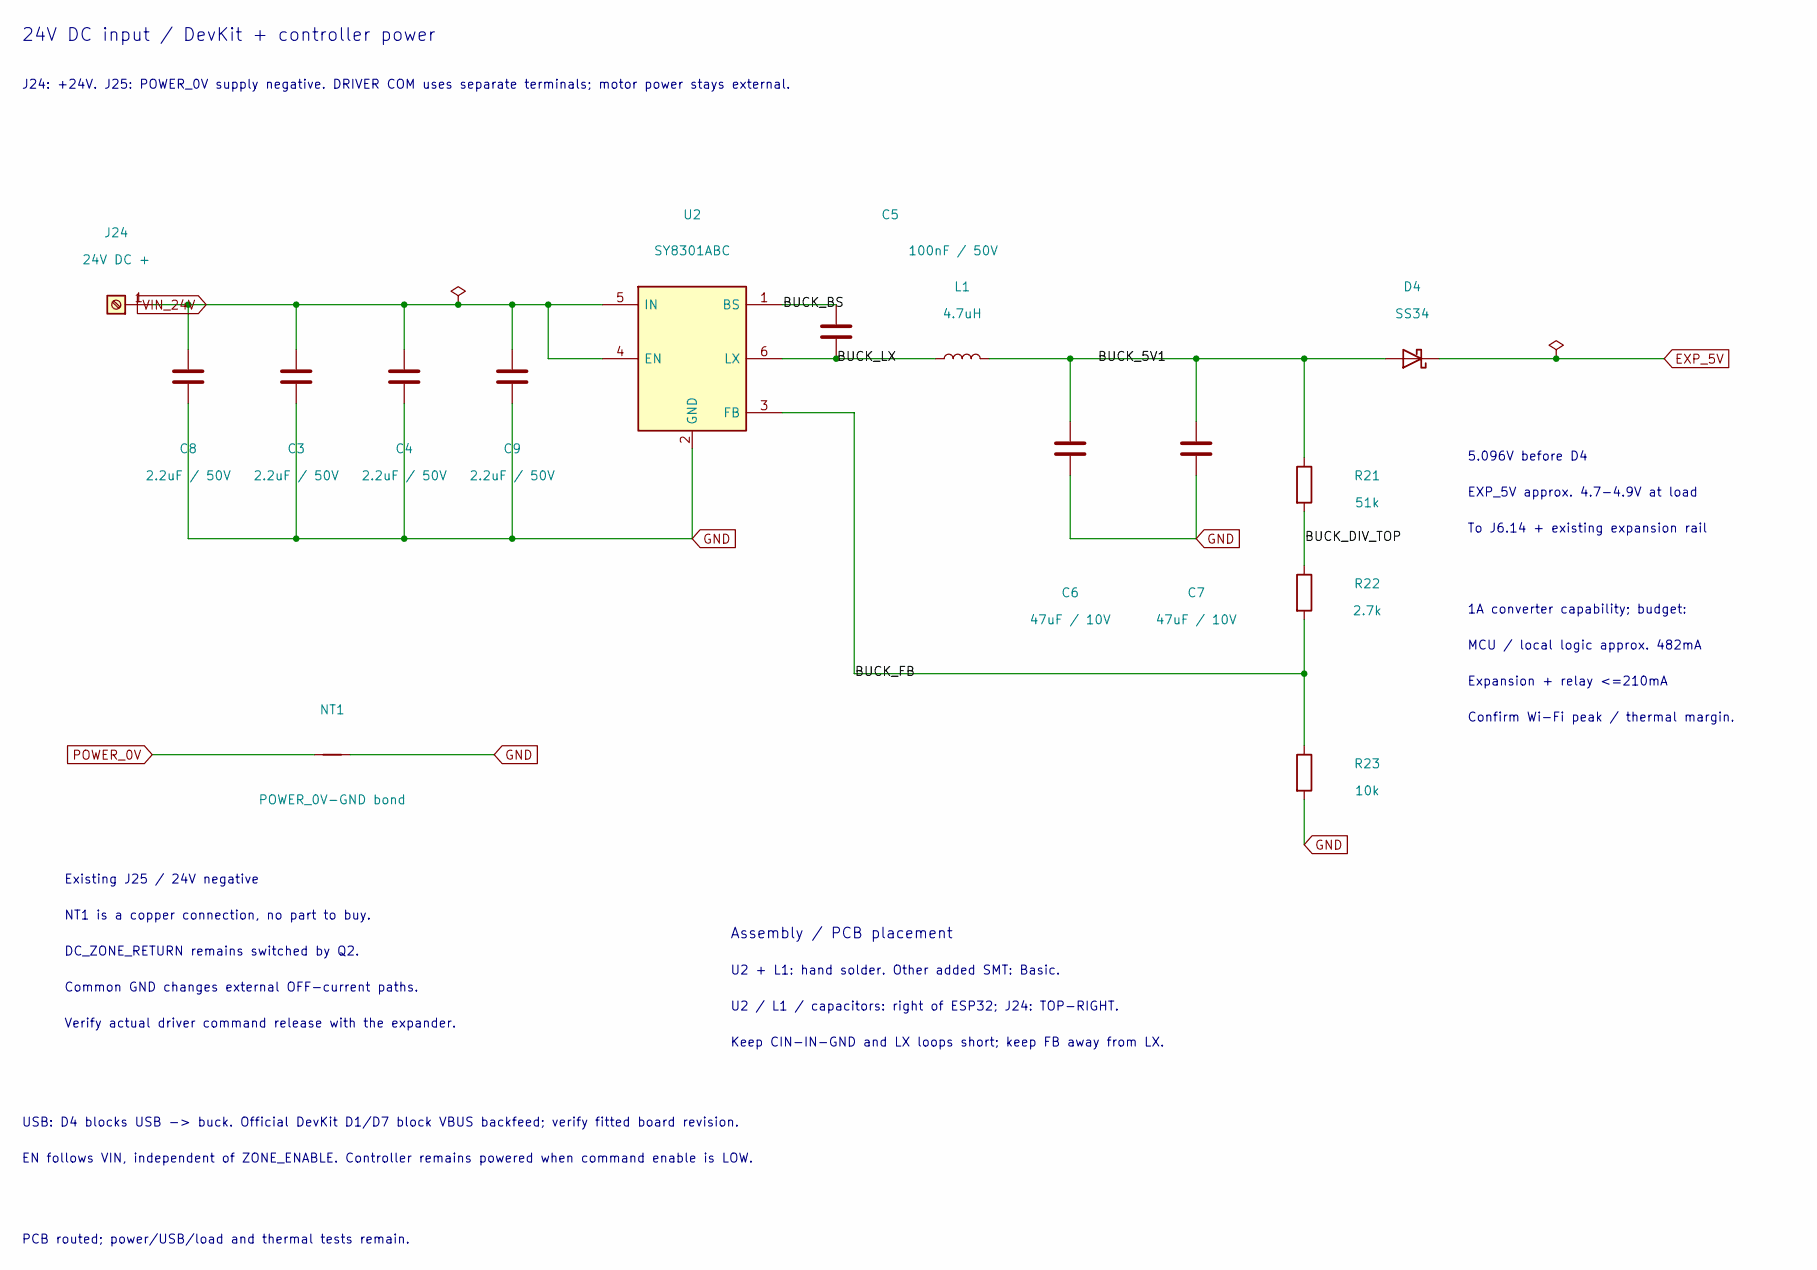
[picture p18: schematic ulva_power.kicad_sch, Ulva / 24V to 5V logic supply]

Parts:
C3, C4, C8, C9: 2.2uF / 50V; C_1206_3216Metric; MPN CL31B225KBHNNNE; LCSC C50254
C5: 100nF / 50V; C_0603_1608Metric; MPN CC0603KRX7R9BB104; LCSC C14663
C6, C7: 47uF / 10V; C_1206_3216Metric; MPN CL31A476MPHNNNE; LCSC C96123
D4: SS34; D_SMA; MPN SS34; LCSC C8678
J24: 24V DC +; TerminalBlock_MetzConnect_360272_1x01_Horizontal_ScrewM2.6; MPN 360272
L1: 4.7uH; L_Sunlord_SWPA6045_6x6mm; MPN SWPA6045S4R7MT; LCSC C78804
NT1: POWER_0V-GND bond; NetTie-2_SMD_Pad2.0mm
R21: 51k; R_0603_1608Metric; MPN 0603WAF5102T5E; LCSC C23196
R22: 2.7k; R_0603_1608Metric; MPN 0603WAF2701T5E; LCSC C13167
R23: 10k; R_0603_1608Metric; MPN 0603WAF1002T5E; LCSC C25804
U2: SY8301ABC; SOT-23-6_Handsoldering; MPN SY8301ABC; LCSC C2927130

Connections:
/5 / 24V power/BUCK_5V1: C6.1, C7.1, D4.2 (A), L1.2, R21.1
/5 / 24V power/BUCK_BS: C5.1, U2.1 (BS)
/5 / 24V power/BUCK_DIV_TOP: R21.2, R22.1
/5 / 24V power/BUCK_FB: R22.2, R23.1, U2.3 (FB)
/5 / 24V power/BUCK_LX: C5.2, L1.1, U2.6 (LX)
EXP_5V: D4.1 (K); also elsewhere on the board
GND: C3.2, C4.2, C6.2, C7.2, C8.2, C9.2, NT1.2, R23.2, U2.2 (GND); also elsewhere on the board
POWER_0V: NT1.1; also elsewhere on the board
VIN_24V: C3.1, C4.1, C8.1, C9.1, J24.1, U2.4 (EN), U2.5 (IN); also elsewhere on the board

Notes on the sheet:
24V DC input / DevKit + controller power
J24: +24V. J25: POWER_0V supply negative. DRIVER COM uses separate terminals; motor power stays external.
5.096V before D4
EXP_5V approx. 4.7-4.9V at load
To J6.14 + existing expansion rail
1A converter capability; budget:
MCU / local logic approx. 482mA
Expansion + relay <=210mA
Confirm Wi-Fi peak / thermal margin.
Existing J25 / 24V negative
NT1 is a copper connection, no part to buy.
DC_ZONE_RETURN remains switched by Q2.
Common GND changes external OFF-current paths.
Verify actual driver command release with the expander.
Assembly / PCB placement
U2 + L1: hand solder. Other added SMT: Basic.
U2 / L1 / capacitors: right of ESP32; J24: TOP-RIGHT.
Keep CIN-IN-GND and LX loops short; keep FB away from LX.
USB: D4 blocks USB -> buck. Official DevKit D1/D7 block VBUS backfeed; verify fitted board revision.
EN follows VIN, independent of ZONE_ENABLE. Controller remains powered when command enable is LOW.
PCB routed; power/USB/load and thermal tests remain.

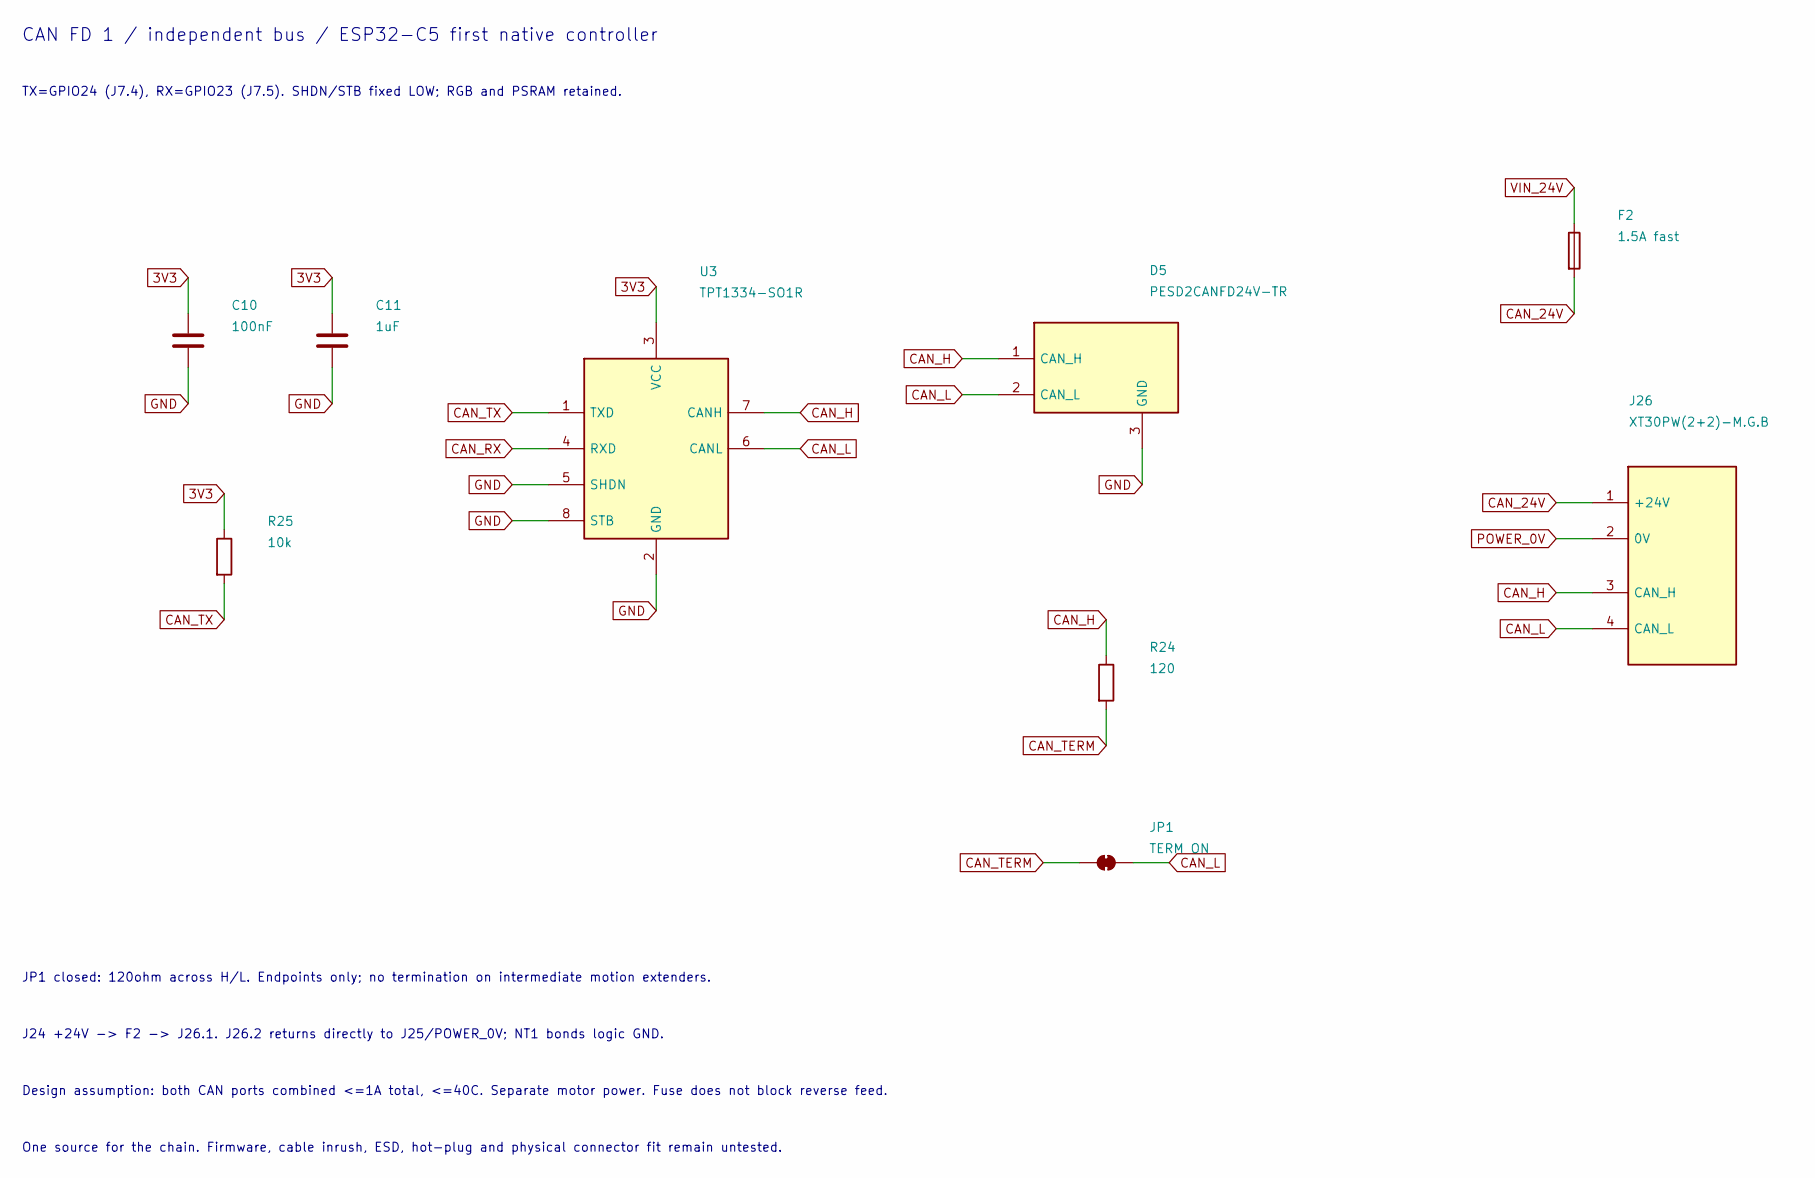
[picture p19: schematic ulva_can.kicad_sch, Ulva / CAN FD channel 1 + fused 24V power]

Parts:
C10: 100nF; C_0603_1608Metric; MPN CC0603KRX7R9BB104; LCSC C14663
C11: 1uF; C_0603_1608Metric; MPN CL10A105KB8NNNC; LCSC C15849
D5: PESD2CANFD24V-TR; SOT-23; MPN PESD2CANFD24V-TR; LCSC C552486
F2: 1.5A fast; Fuse_Littelfuse_467_0603; MPN 046701.5NRHF; LCSC C187608
J26: XT30PW(2+2)-M.G.B; AMASS_XT30PW_2plus2_M_Horizontal; MPN XT30PW(2+2)-M.G.B; LCSC C19268030
JP1: TERM ON; SolderJumper-2_P1.3mm_Bridged_Pad1.0x1.5mm
R24: 120; R_1206_3216Metric; MPN 1206W4F1200T5E; LCSC C17909
R25: 10k; R_0603_1608Metric; MPN 0603WAF1002T5E; LCSC C25804
U3: TPT1334-SO1R; SOIC-8_3.9x4.9mm_P1.27mm; MPN TPT1334-SO1R; LCSC C44859616

Connections:
3V3: C10.1, C11.1, R25.1, U3.3 (VCC); also elsewhere on the board
CAN_24V: F2.2, J26.1 (+24V)
CAN_H: D5.1 (CAN_H), J26.3 (CAN_H), R24.1, U3.7 (CANH)
CAN_L: D5.2 (CAN_L), J26.4 (CAN_L), JP1.2 (B), U3.6 (CANL)
CAN_RX: U3.4 (RXD); also elsewhere on the board
CAN_TERM: JP1.1 (A), R24.2
CAN_TX: R25.2, U3.1 (TXD); also elsewhere on the board
GND: C10.2, C11.2, D5.3 (GND), U3.2 (GND), U3.5 (SHDN), U3.8 (STB); also elsewhere on the board
POWER_0V: J26.2 (0V); also elsewhere on the board
VIN_24V: F2.1; also elsewhere on the board

Notes on the sheet:
CAN FD 1 / independent bus / ESP32-C5 first native controller
TX=GPIO24 (J7.4), RX=GPIO23 (J7.5). SHDN/STB fixed LOW; RGB and PSRAM retained.
JP1 closed: 120ohm across H/L. Endpoints only; no termination on intermediate motion extenders.
J24 +24V -> F2 -> J26.1. J26.2 returns directly to J25/POWER_0V; NT1 bonds logic GND.
Design assumption: both CAN ports combined <=1A total, <=40C. Separate motor power. Fuse does not block reverse feed.
One source for the chain. Firmware, cable inrush, ESD, hot-plug and physical connector fit remain untested.
