ivere27/ulva/ulva_controller.kicad_pcb

## KiCad design ulva_controller.kicad_pcb (continued)

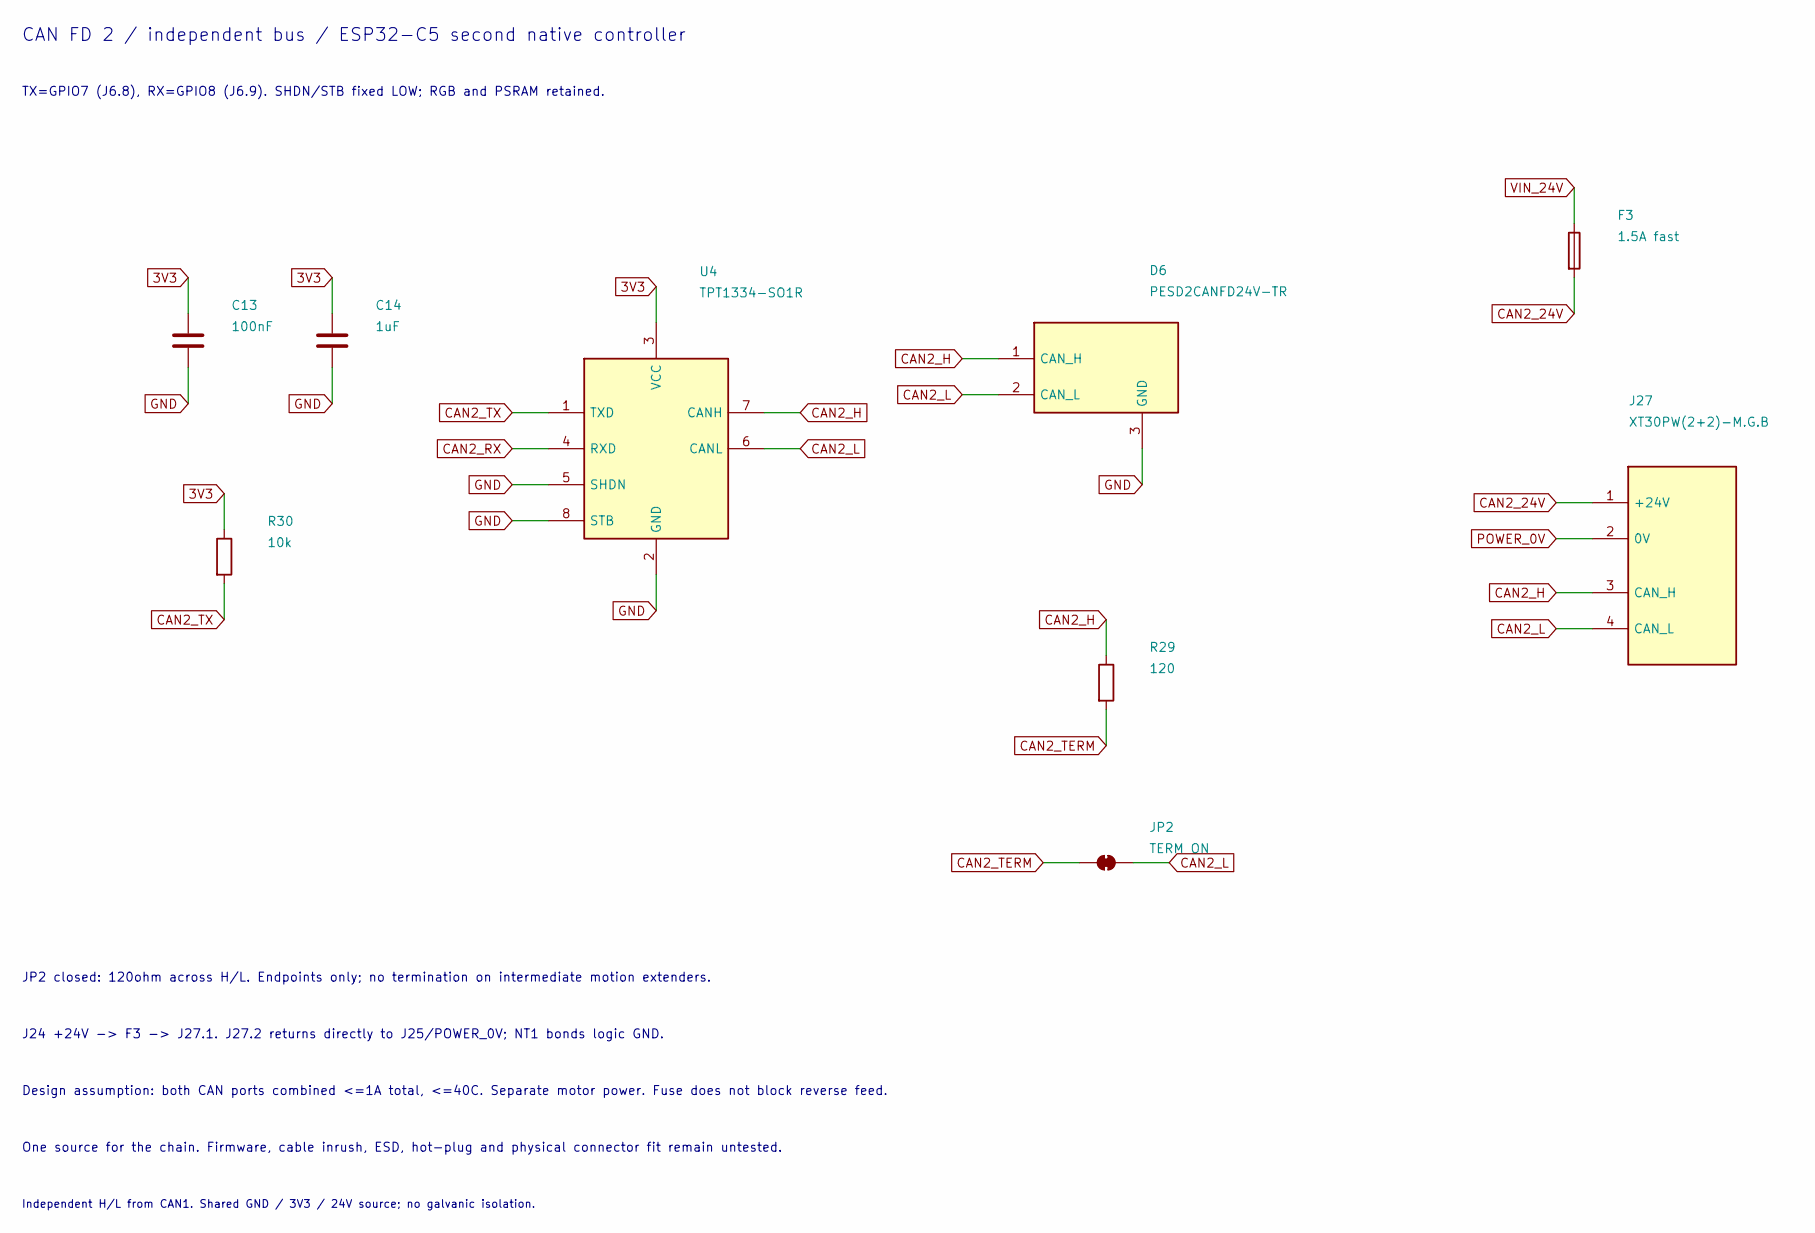
[picture p20: schematic ulva_can2.kicad_sch, Ulva / CAN FD channel 2 + fused 24V power]

Parts:
C13: 100nF; C_0603_1608Metric; MPN CC0603KRX7R9BB104; LCSC C14663
C14: 1uF; C_0603_1608Metric; MPN CL10A105KB8NNNC; LCSC C15849
D6: PESD2CANFD24V-TR; SOT-23; MPN PESD2CANFD24V-TR; LCSC C552486
F3: 1.5A fast; Fuse_Littelfuse_467_0603; MPN 046701.5NRHF; LCSC C187608
J27: XT30PW(2+2)-M.G.B; AMASS_XT30PW_2plus2_M_Horizontal; MPN XT30PW(2+2)-M.G.B; LCSC C19268030
JP2: TERM ON; SolderJumper-2_P1.3mm_Bridged_Pad1.0x1.5mm
R29: 120; R_1206_3216Metric; MPN 1206W4F1200T5E; LCSC C17909
R30: 10k; R_0603_1608Metric; MPN 0603WAF1002T5E; LCSC C25804
U4: TPT1334-SO1R; SOIC-8_3.9x4.9mm_P1.27mm; MPN TPT1334-SO1R; LCSC C44859616

Connections:
3V3: C13.1, C14.1, R30.1, U4.3 (VCC); also elsewhere on the board
CAN2_24V: F3.2, J27.1 (+24V)
CAN2_H: D6.1 (CAN_H), J27.3 (CAN_H), R29.1, U4.7 (CANH)
CAN2_L: D6.2 (CAN_L), J27.4 (CAN_L), JP2.2 (B), U4.6 (CANL)
CAN2_RX: U4.4 (RXD); also elsewhere on the board
CAN2_TERM: JP2.1 (A), R29.2
CAN2_TX: R30.2, U4.1 (TXD); also elsewhere on the board
GND: C13.2, C14.2, D6.3 (GND), U4.2 (GND), U4.5 (SHDN), U4.8 (STB); also elsewhere on the board
POWER_0V: J27.2 (0V); also elsewhere on the board
VIN_24V: F3.1; also elsewhere on the board

Notes on the sheet:
CAN FD 2 / independent bus / ESP32-C5 second native controller
TX=GPIO7 (J6.8), RX=GPIO8 (J6.9). SHDN/STB fixed LOW; RGB and PSRAM retained.
JP2 closed: 120ohm across H/L. Endpoints only; no termination on intermediate motion extenders.
J24 +24V -> F3 -> J27.1. J27.2 returns directly to J25/POWER_0V; NT1 bonds logic GND.
Design assumption: both CAN ports combined <=1A total, <=40C. Separate motor power. Fuse does not block reverse feed.
One source for the chain. Firmware, cable inrush, ESD, hot-plug and physical connector fit remain untested.
Independent H/L from CAN1. Shared GND / 3V3 / 24V source; no galvanic isolation.

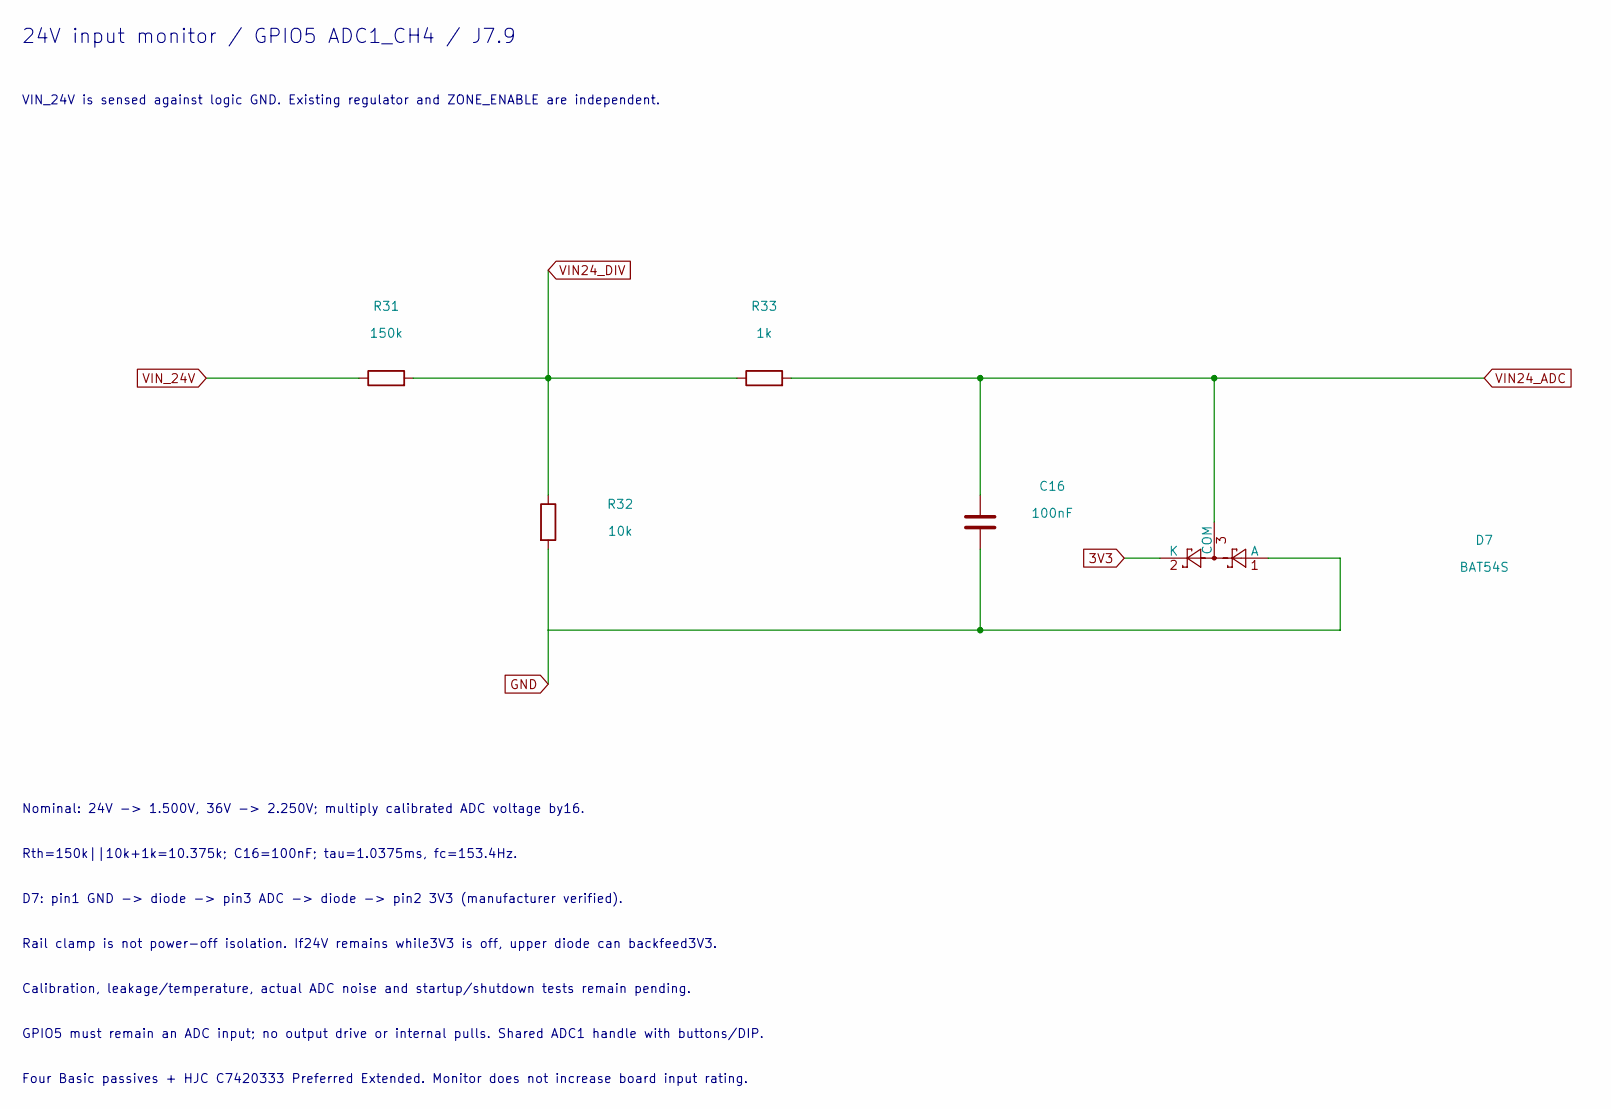
[picture p21: schematic ulva_monitor.kicad_sch, Ulva / 24V ADC monitor]

Parts:
C16: 100nF; C_0603_1608Metric; MPN CC0603KRX7R9BB104; LCSC C14663
D7: BAT54S; SOT-23; MPN BAT54S; LCSC C7420333
R31: 150k; R_0603_1608Metric; MPN 0603WAF1503T5E; LCSC C22807
R32: 10k; R_0603_1608Metric; MPN 0603WAF1002T5E; LCSC C25804
R33: 1k; R_0603_1608Metric; MPN 0603WAF1001T5E; LCSC C21190

Connections:
3V3: D7.2 (K); also elsewhere on the board
GND: C16.2, D7.1 (A), R32.2; also elsewhere on the board
VIN24_ADC: C16.1, D7.3 (COM), R33.2; also elsewhere on the board
VIN24_DIV: R31.2, R32.1, R33.1
VIN_24V: R31.1; also elsewhere on the board

Notes on the sheet:
24V input monitor / GPIO5 ADC1_CH4 / J7.9
VIN_24V is sensed against logic GND. Existing regulator and ZONE_ENABLE are independent.
Nominal: 24V -> 1.500V, 36V -> 2.250V; multiply calibrated ADC voltage by16.
Rth=150k||10k+1k=10.375k; C16=100nF; tau=1.0375ms, fc=153.4Hz.
D7: pin1 GND -> diode -> pin3 ADC -> diode -> pin2 3V3 (manufacturer verified).
Rail clamp is not power-off isolation. If24V remains while3V3 is off, upper diode can backfeed3V3.
Calibration, leakage/temperature, actual ADC noise and startup/shutdown tests remain pending.
GPIO5 must remain an ADC input; no output drive or internal pulls. Shared ADC1 handle with buttons/DIP.
Four Basic passives + HJC C7420333 Preferred Extended. Monitor does not increase board input rating.

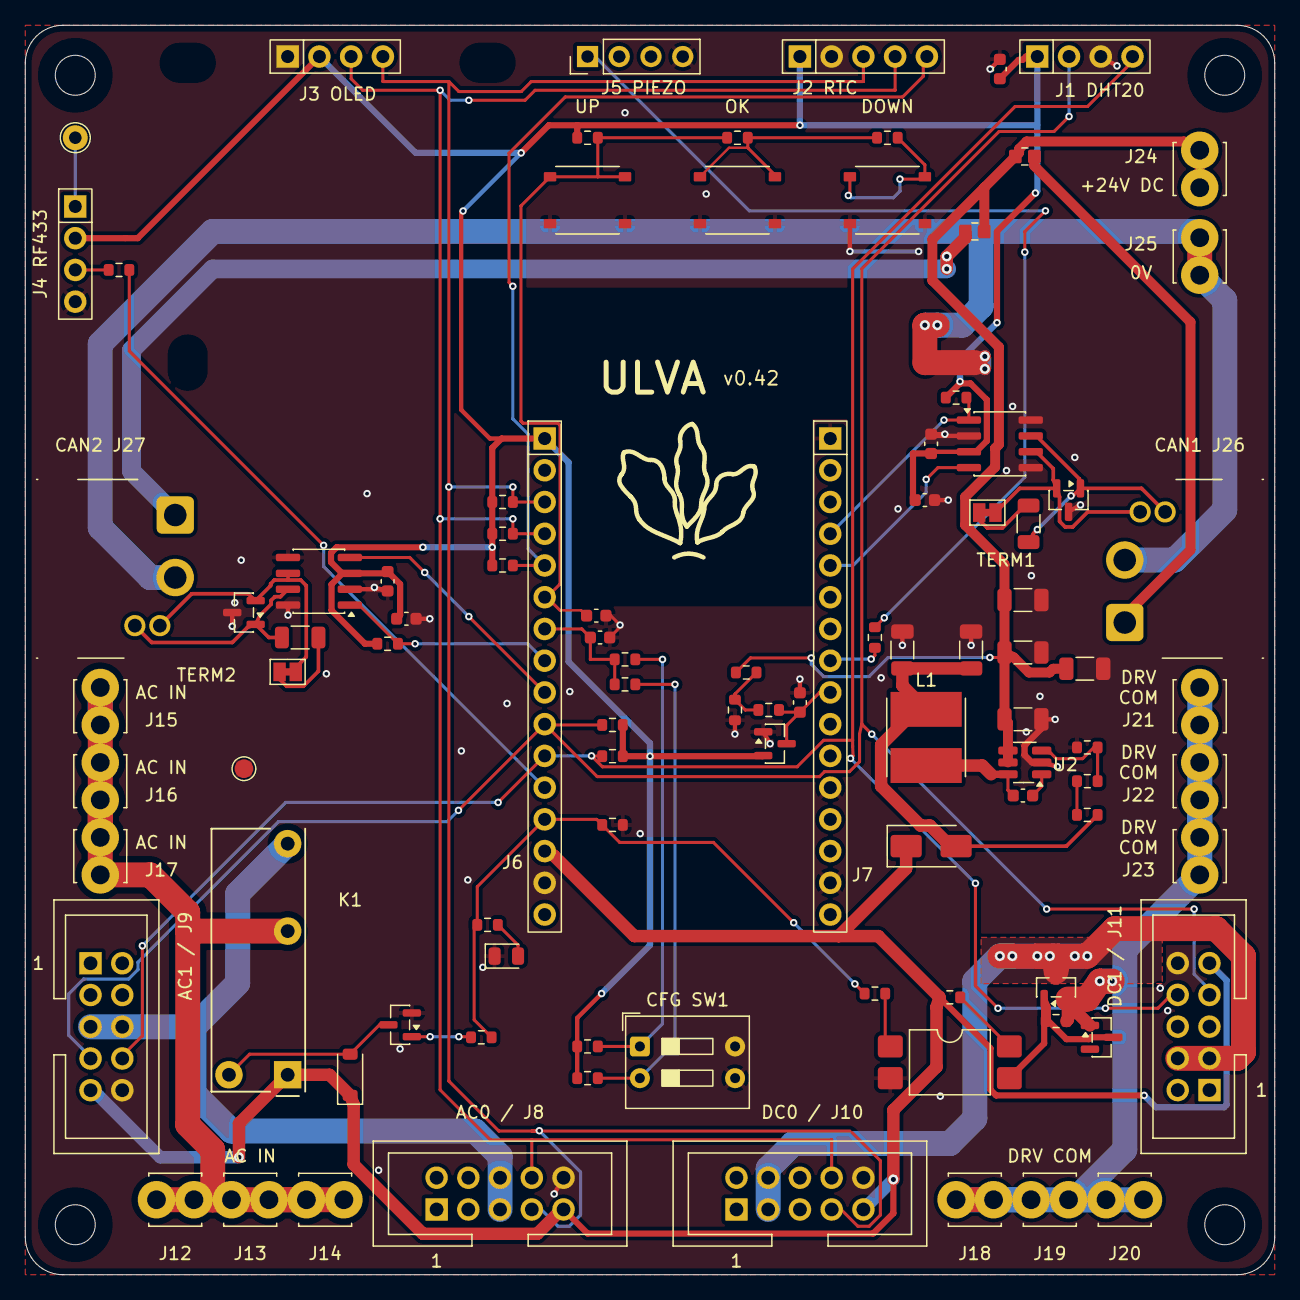
[picture p22: board ulva_controller.kicad_pcb from above]

Board: 2 copper layers, 100.0 x 100.0 mm, 106 parts (0 on the bottom side), 51 nets.
